darwinbeing/HPServerPSUHack/resources/PD52_04F/readme.md

# ICSP Header pinout
- 1 - GND
- 2 - MCLR
- 3 - PGED2
- 4 - PGEC2
- 5 - VDD

# Pickit 3 Pinout
- 1 - MCLR
- 2 - VDD
- 3 - GND
- 4 - PGD
- 5 - PGC

# Resistor values to modify output voltage
Originally both marked resistors are 20k
If changed to:
 - 23.2k = ~13.8V
 - 24k = ~14.2V
 - 24.3k = ~14.4V
