darwinbeing/HPServerPSUHack/firmware/PICKit3-Pinout.png

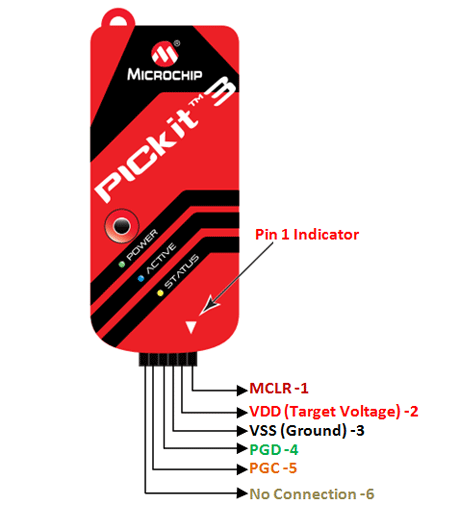
firmware/PICKit3-Pinout.png
