darwinbeing/HPServerPSUHack/references/dpsk3-power-buck-average-current-mode-control-1.0.1/docs/images/average-current-mode-control.png

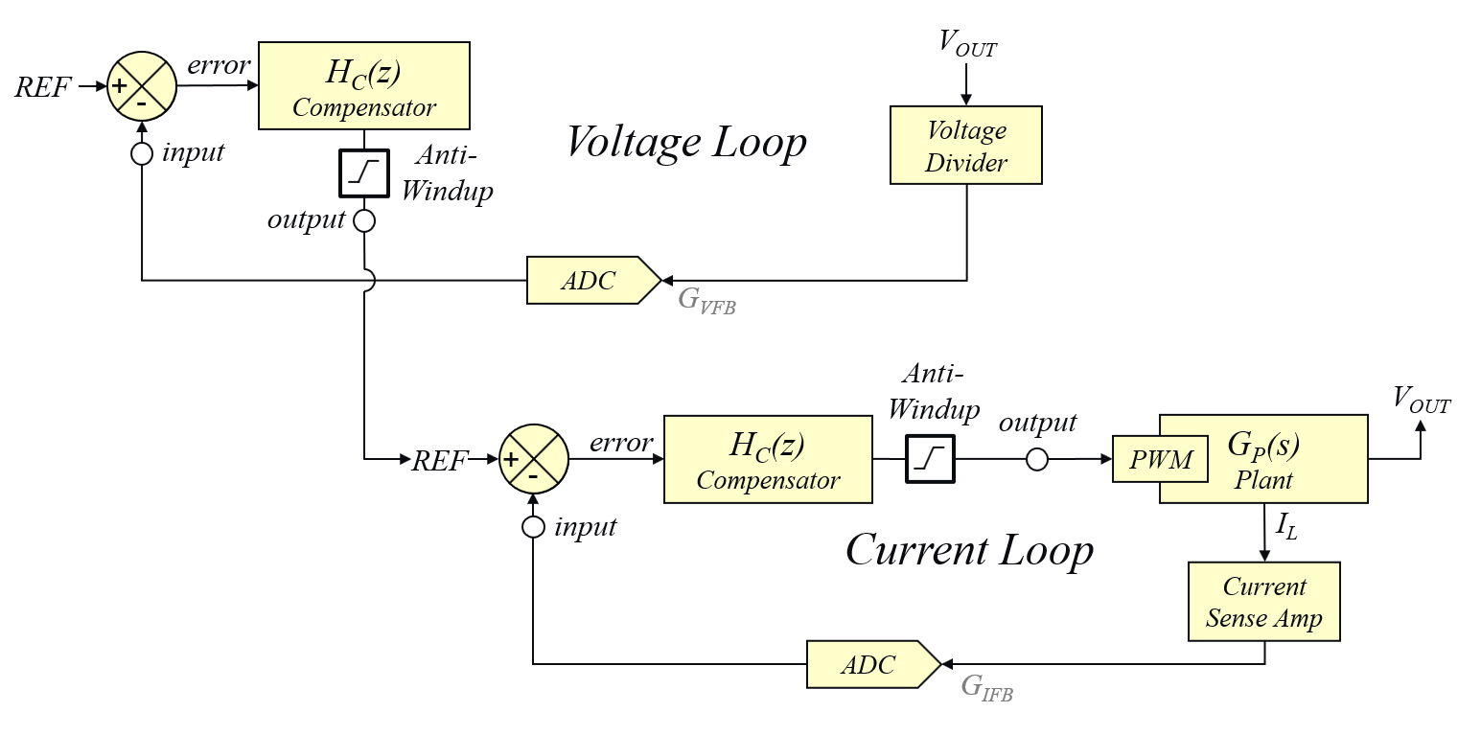
references/dpsk3-power-buck-average-current-mode-control-1.0.1/docs/images/average-current-mode-control.png
