darwinbeing/HPServerPSUHack/references/dpsk3-power-buck-average-current-mode-control-1.0.1/docs/images/control_timing.png

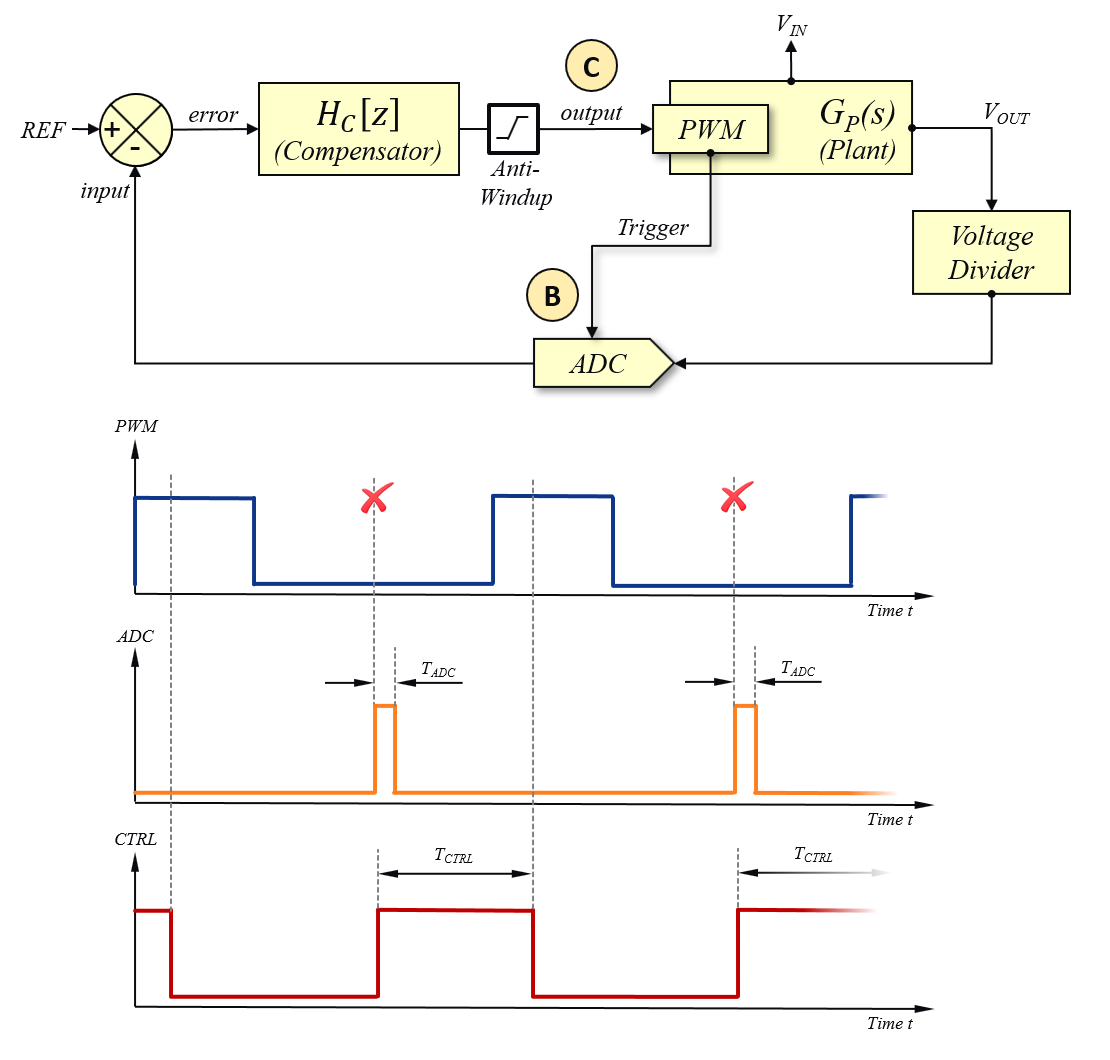
references/dpsk3-power-buck-average-current-mode-control-1.0.1/docs/images/control_timing.png
