darwinbeing/HPServerPSUHack/references/dpsk3-power-buck-average-current-mode-control-1.0.1/docs/images/fault_recovery.png

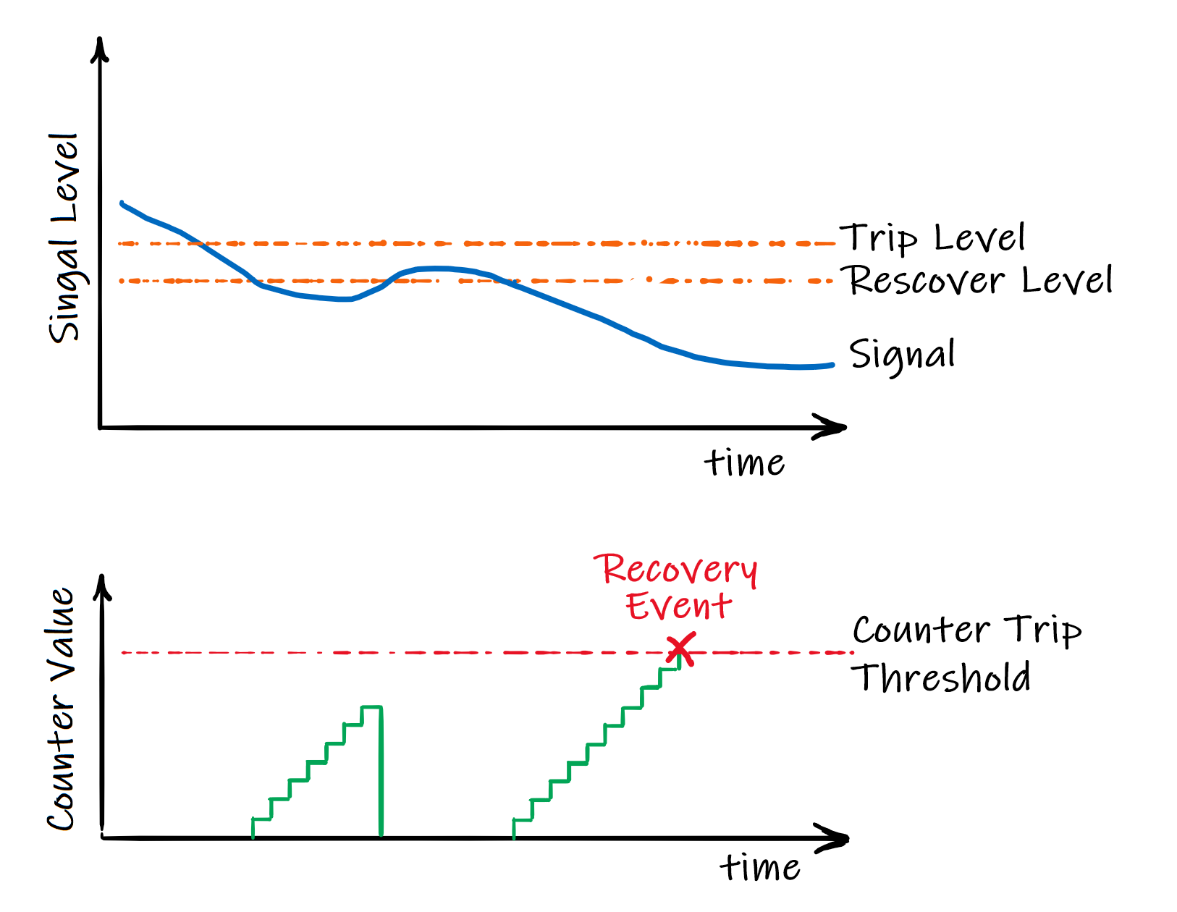
references/dpsk3-power-buck-average-current-mode-control-1.0.1/docs/images/fault_recovery.png
