darwinbeing/HPServerPSUHack/references/dpsk3-power-buck-average-current-mode-control-1.0.1/docs/images/irq_p0-2.png

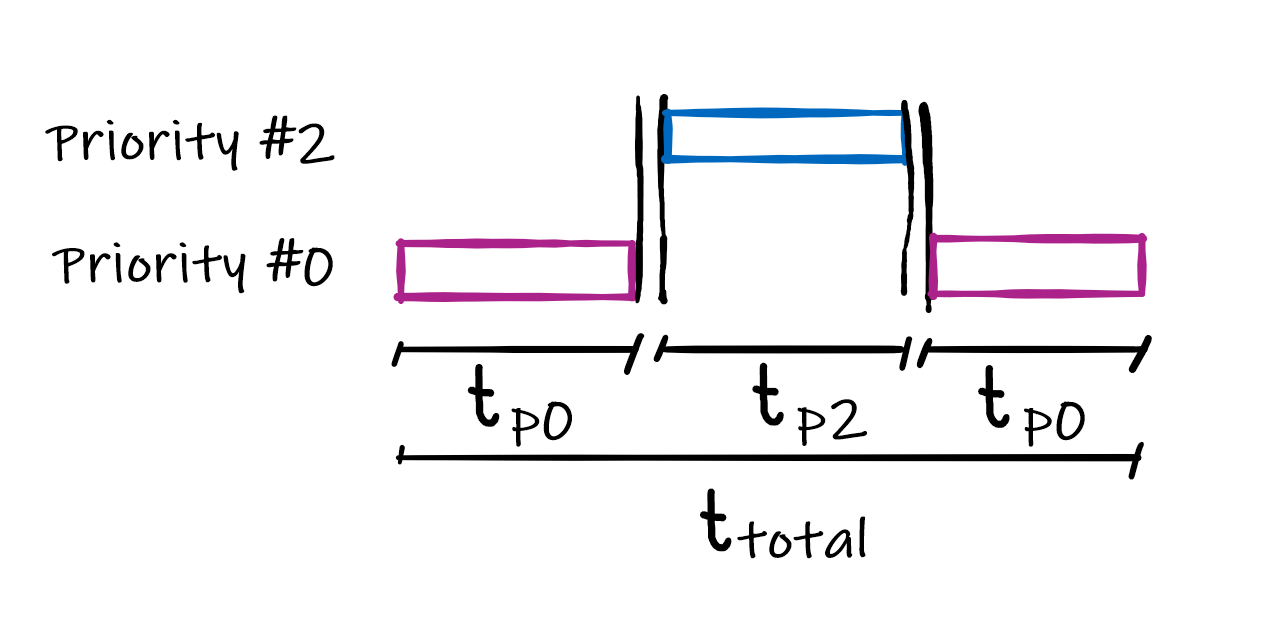
references/dpsk3-power-buck-average-current-mode-control-1.0.1/docs/images/irq_p0-2.png
