darwinbeing/HPServerPSUHack/references/dpsk3-power-buck-average-current-mode-control-1.0.1/docs/images/npnz16b-flowchart-agc.png

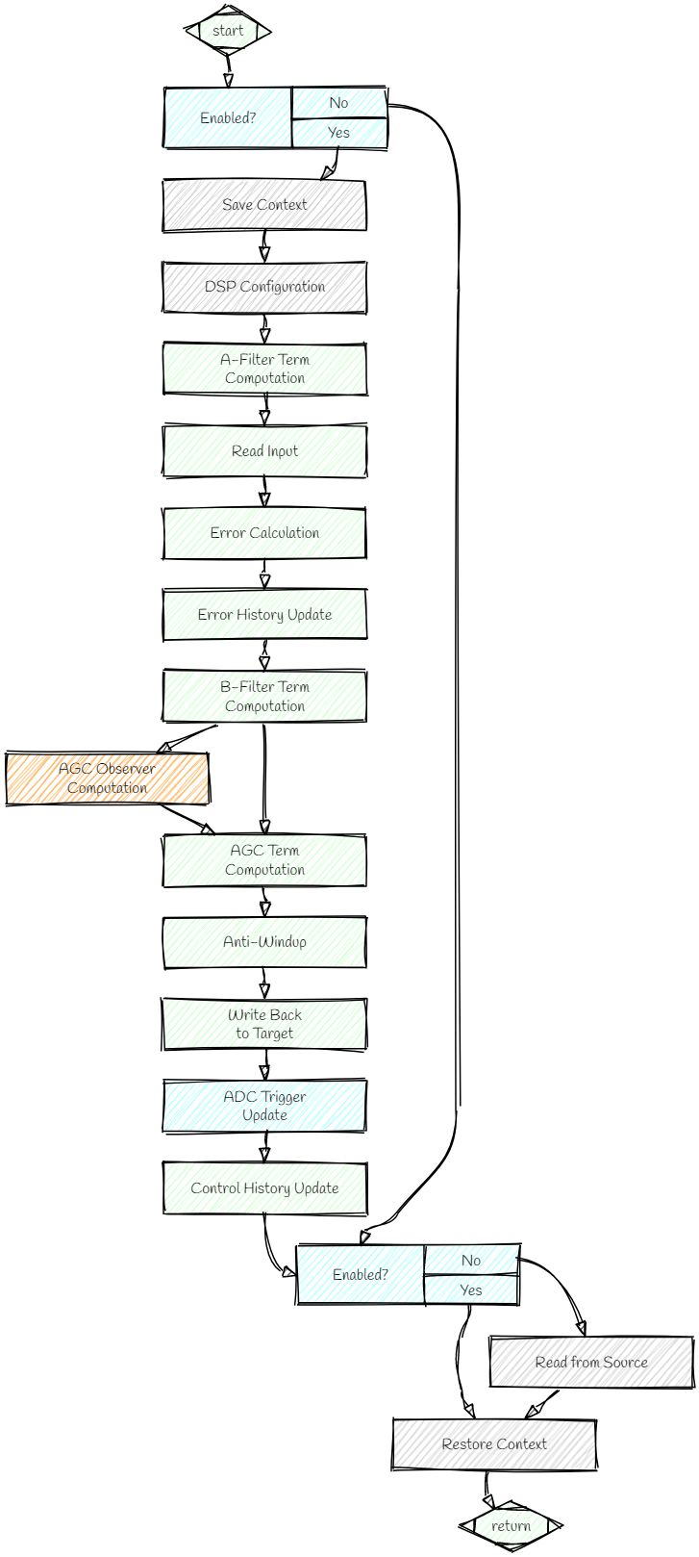
references/dpsk3-power-buck-average-current-mode-control-1.0.1/docs/images/npnz16b-flowchart-agc.png
