darwinbeing/HPServerPSUHack/references/dpsk3-power-buck-average-current-mode-control-1.0.1/docs/images/sfw_main.png

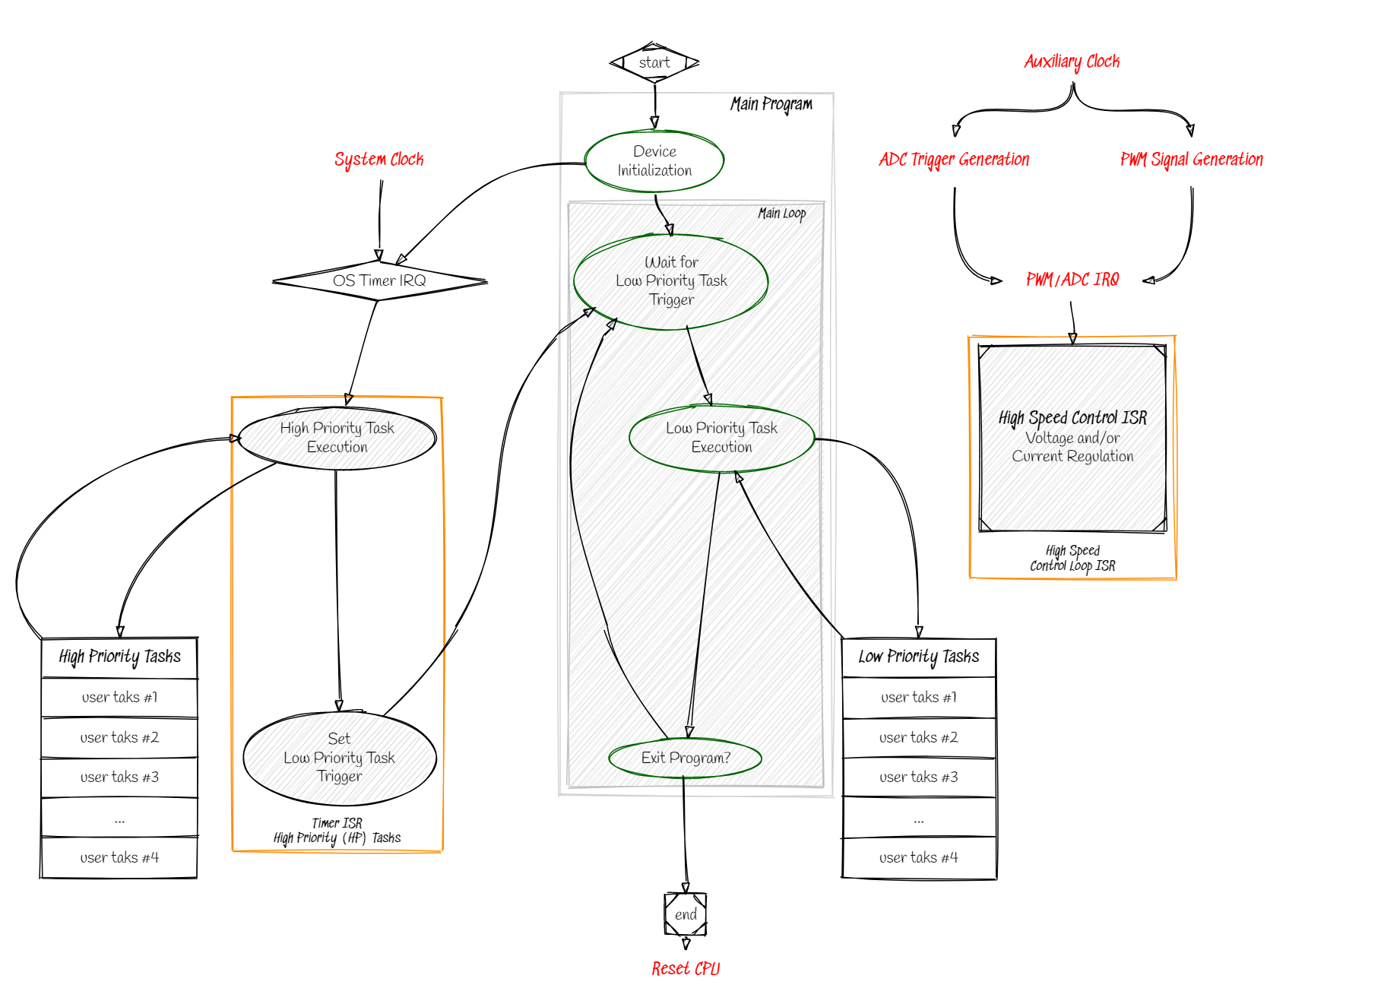
references/dpsk3-power-buck-average-current-mode-control-1.0.1/docs/images/sfw_main.png
