darwinbeing/HPServerPSUHack/references/dpsk3-power-buck-average-current-mode-control-1.0.1/docs/images/voltage-mode-control.png

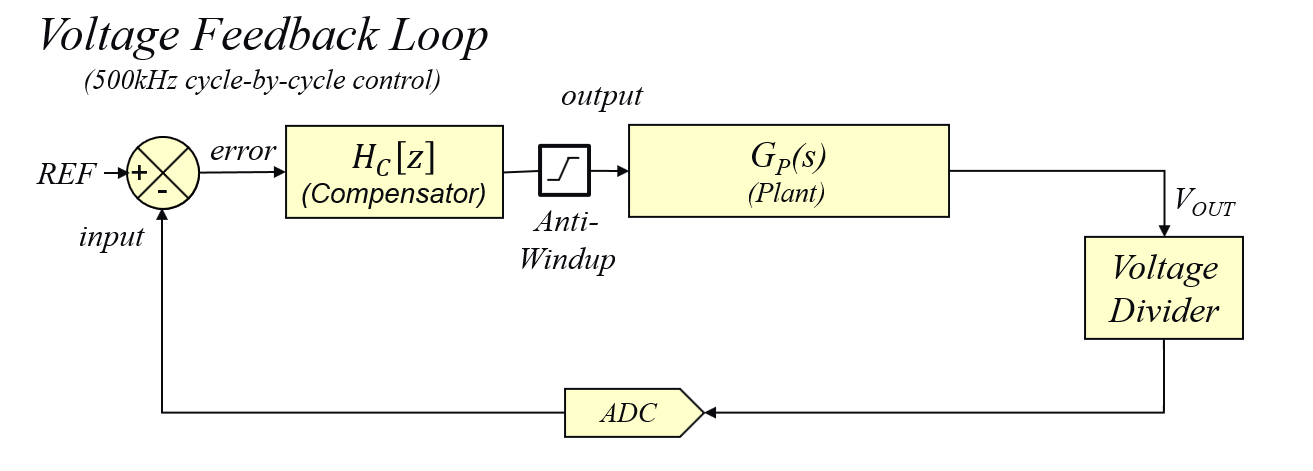
references/dpsk3-power-buck-average-current-mode-control-1.0.1/docs/images/voltage-mode-control.png
