darwinbeing/HPServerPSUHack/resources/cable.jpg

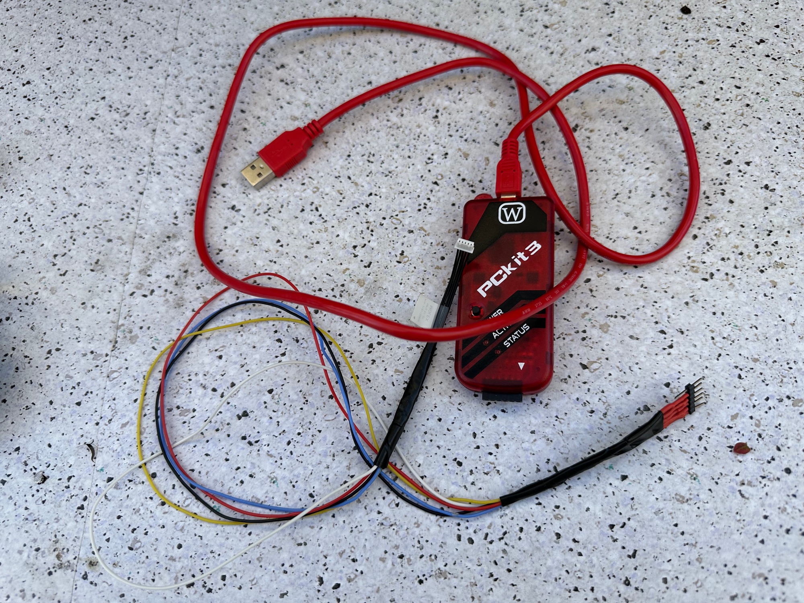
resources/cable.jpg
