darwinbeing/HPServerPSUHack/resources/connector.jpg

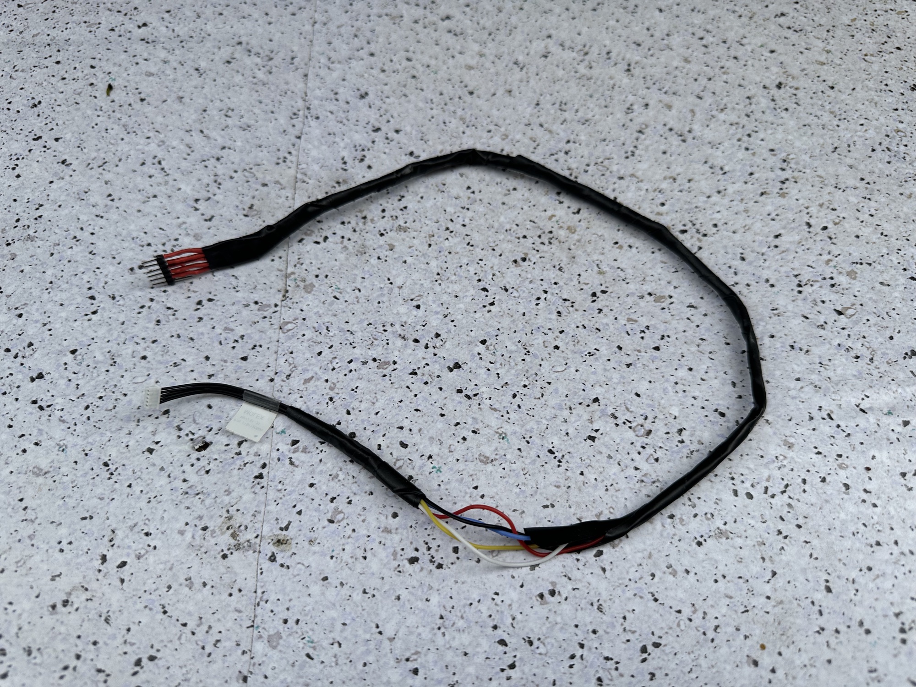
resources/connector.jpg
