darwinbeing/HPServerPSUHack/resources/D1600E-S0_MOD_SCH.png

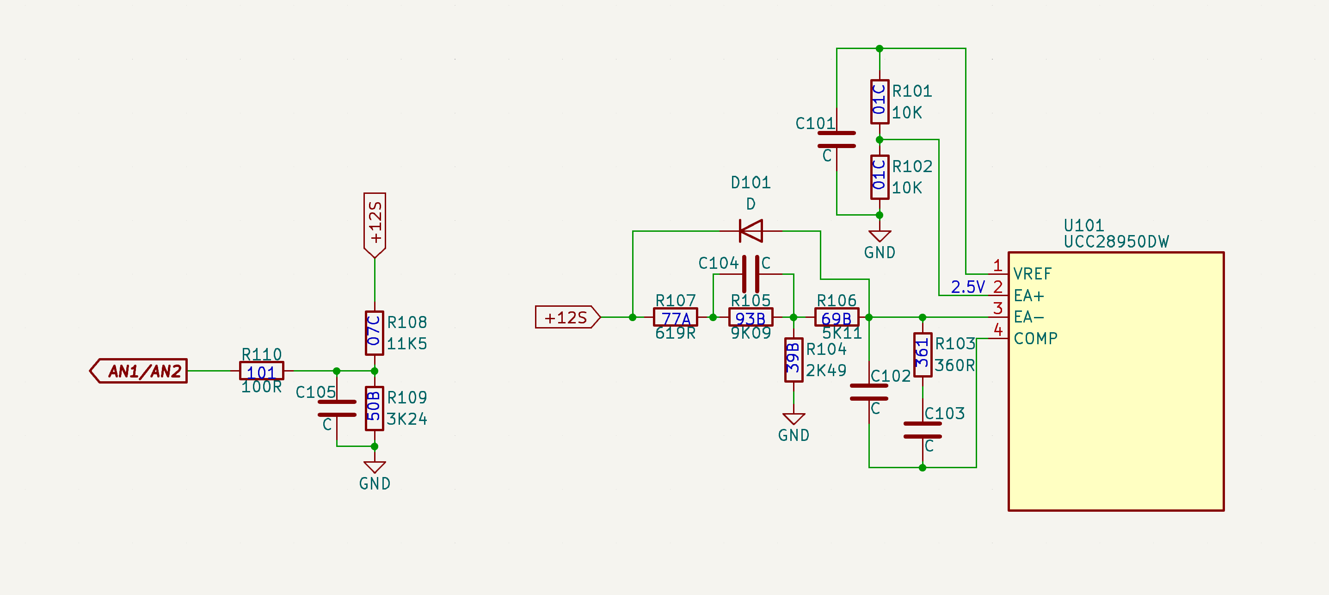
resources/D1600E-S0_MOD_SCH.png
