darwinbeing/HPServerPSUHack/resources/mb_front.jpg

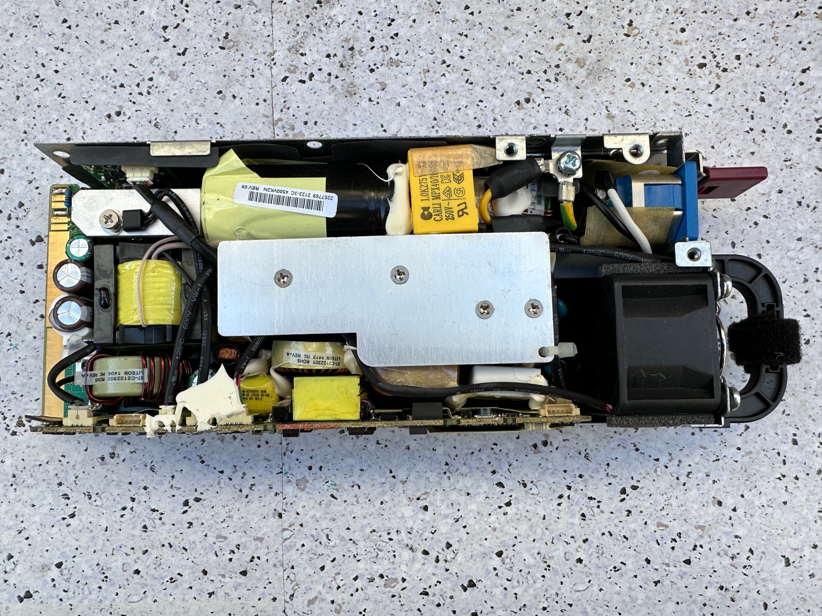
resources/mb_front.jpg
