darwinbeing/HPServerPSUHack/resources/PD19_MOD_SCH.png

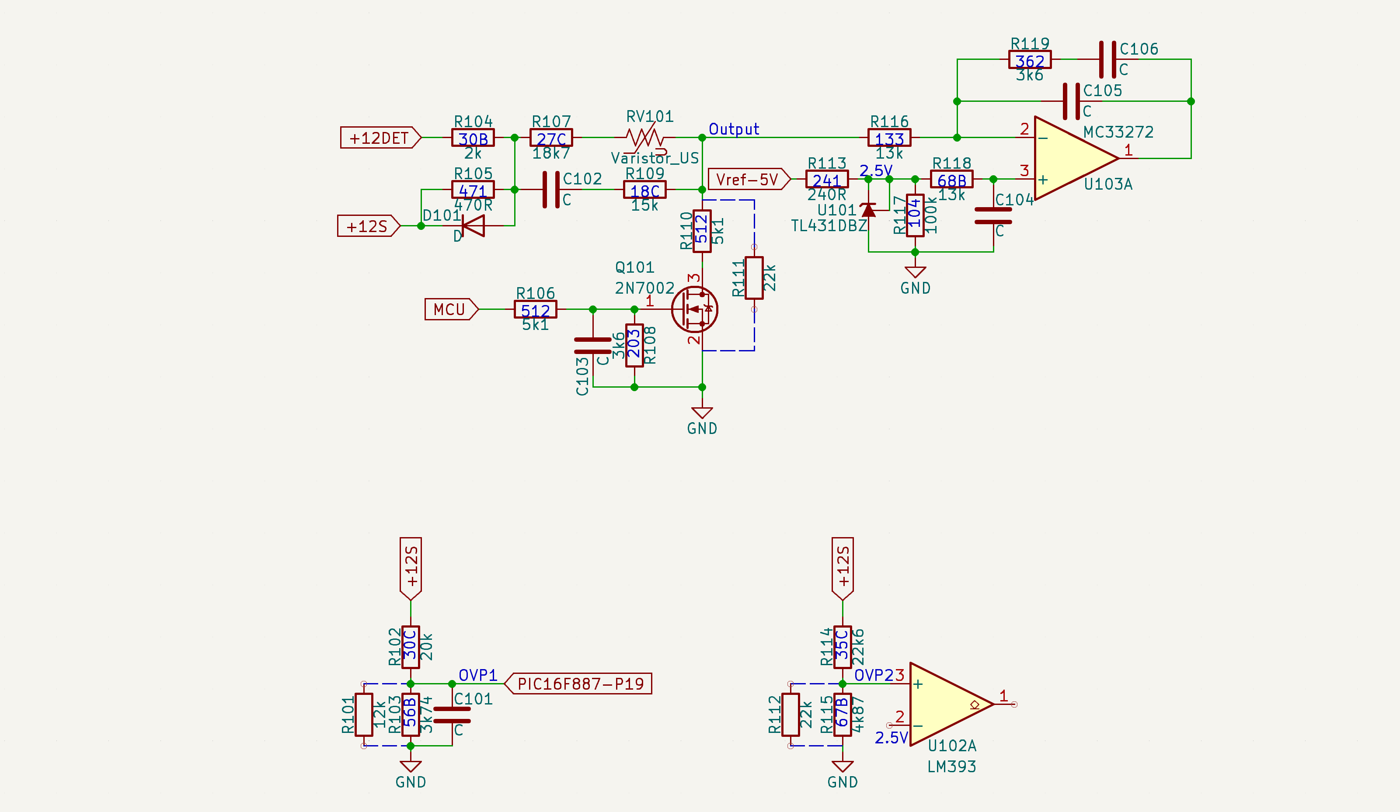
resources/PD19_MOD_SCH.png
