darwinbeing/HPServerPSUHack/resources/PD44_MOD_14V4.jpg

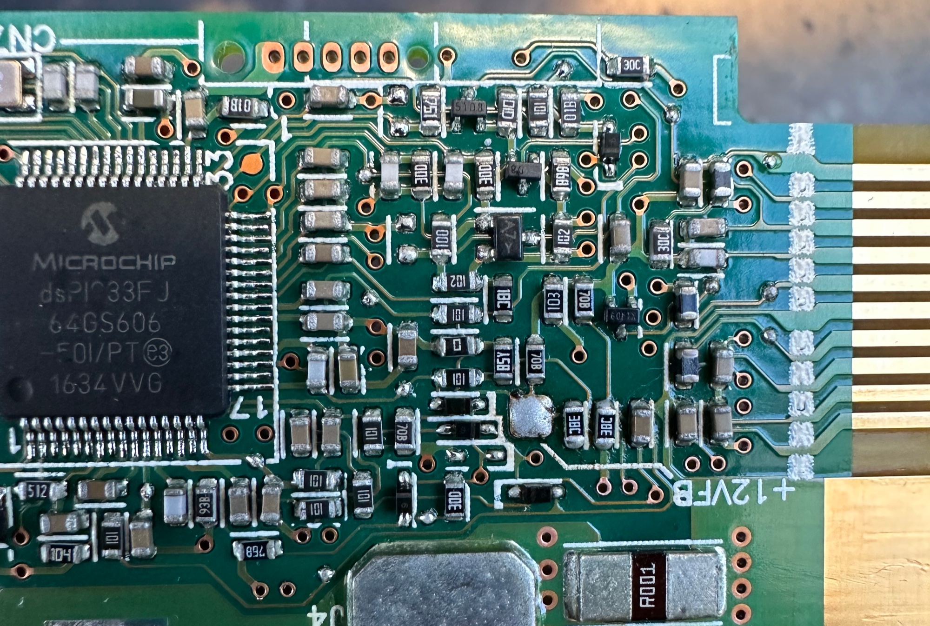
resources/PD44_MOD_14V4.jpg
