darwinbeing/HPServerPSUHack/resources/PD52_04F/icsp_and_pic.jpg

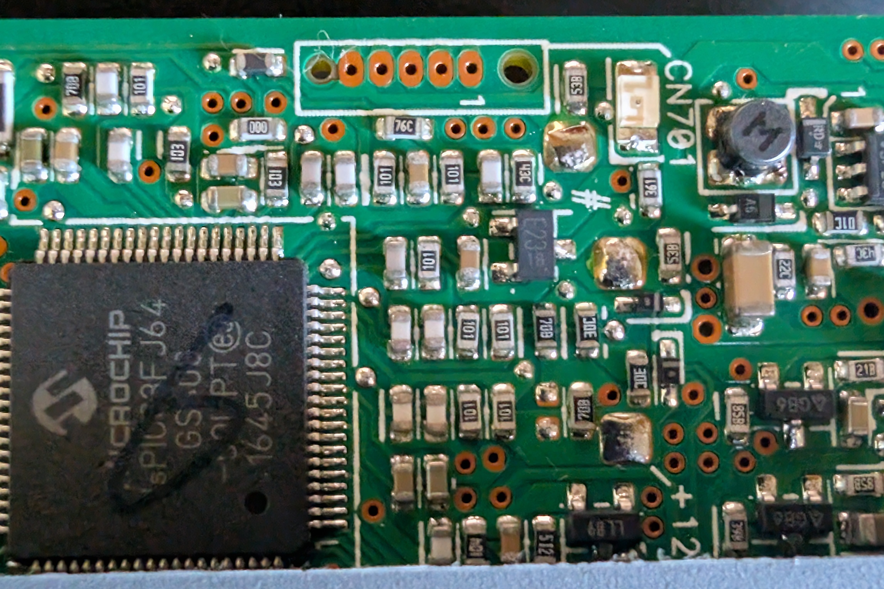
resources/PD52_04F/icsp_and_pic.jpg
