darwinbeing/HPServerPSUHack/resources/PD52_04F/vdiff_resistors.jpg

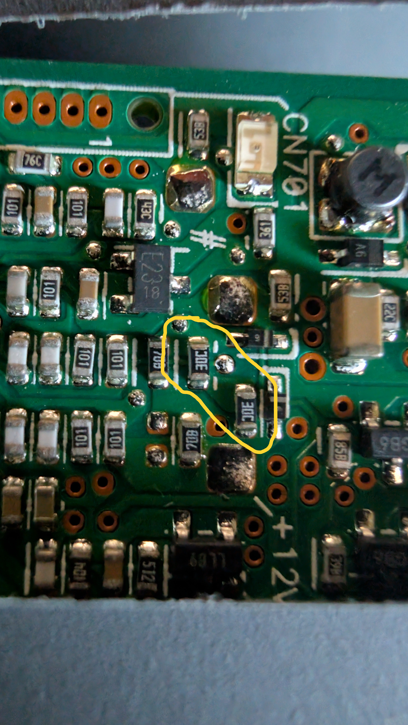
resources/PD52_04F/vdiff_resistors.jpg
