darwinbeing/HPServerPSUHack/resources/pickit3.jpg

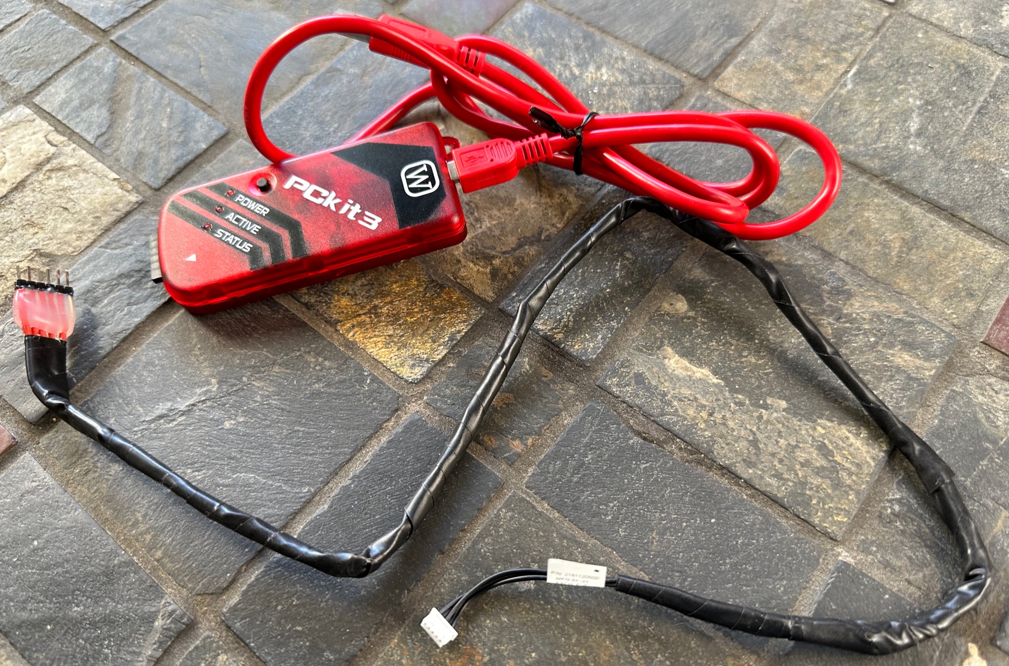
resources/pickit3.jpg
