darwinbeing/HPServerPSUHack/resources/PL11_BMW_LoadWithFanMax.jpg

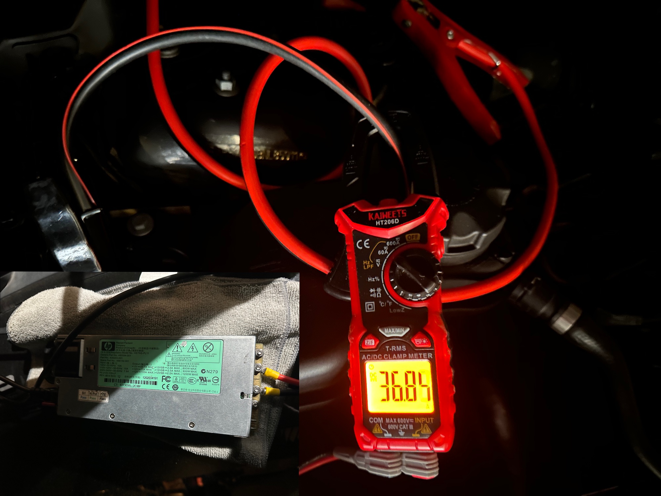
resources/PL11_BMW_LoadWithFanMax.jpg
