darwinbeing/HPServerPSUHack/resources/PL11_OCP_HW.png

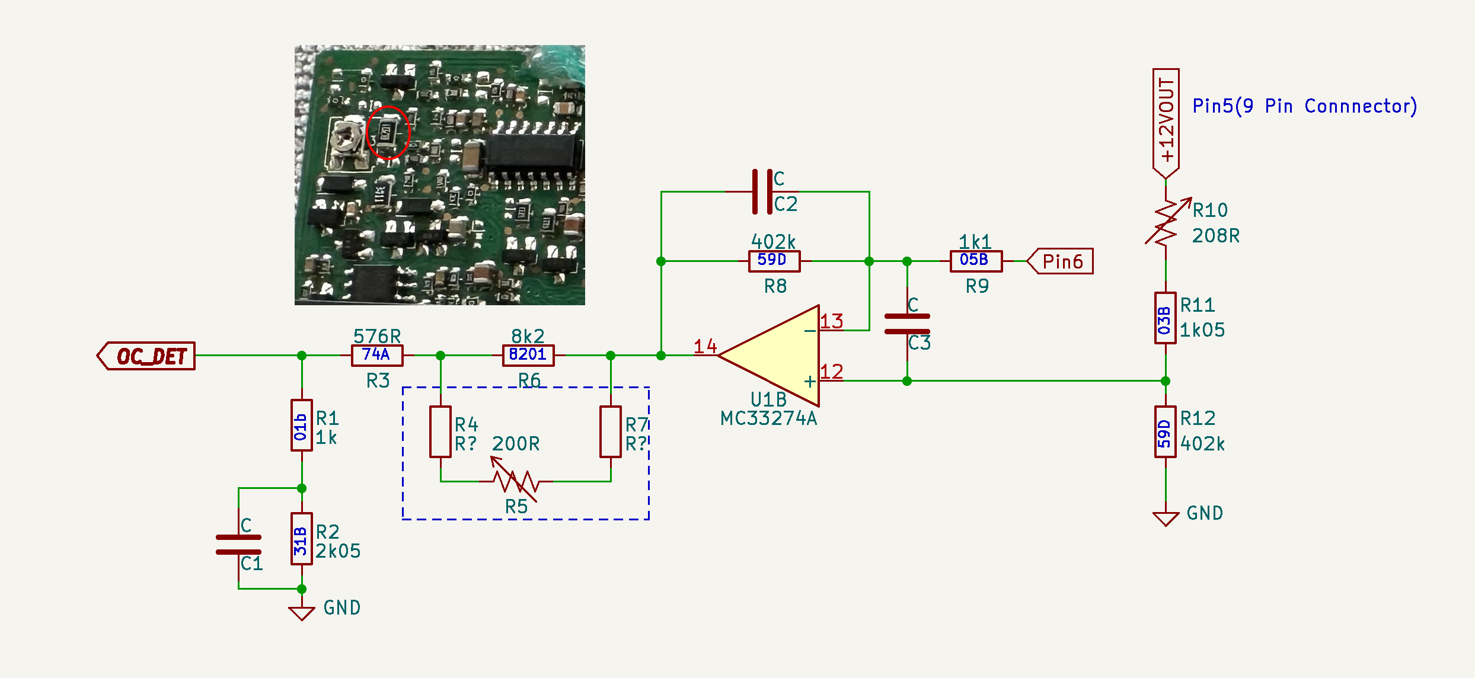
resources/PL11_OCP_HW.png
