darwinbeing/HPServerPSUHack/resources/PL30.jpg

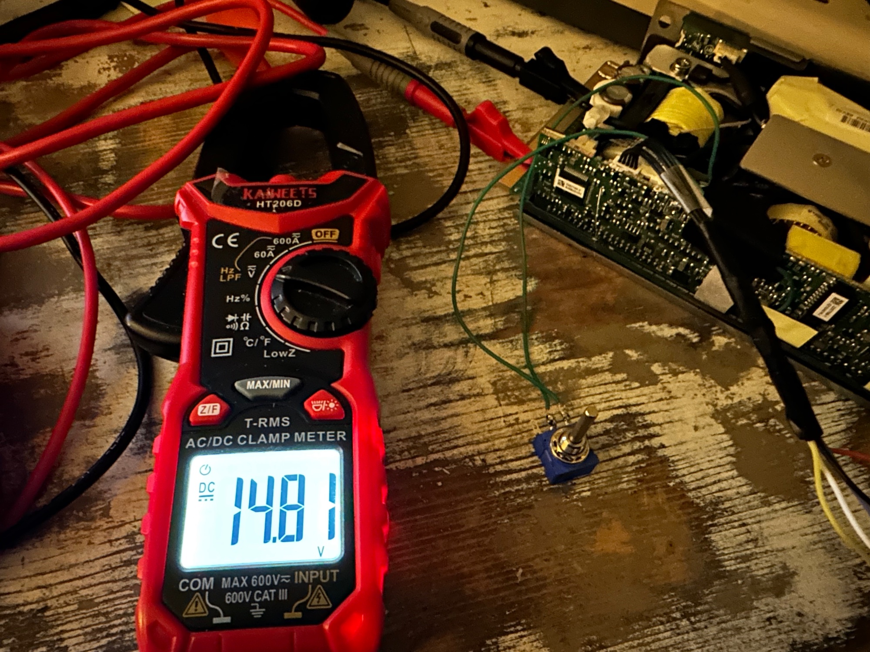
resources/PL30.jpg
