darwinbeing/HPServerPSUHack/resources/PL30_OCP_HW.png

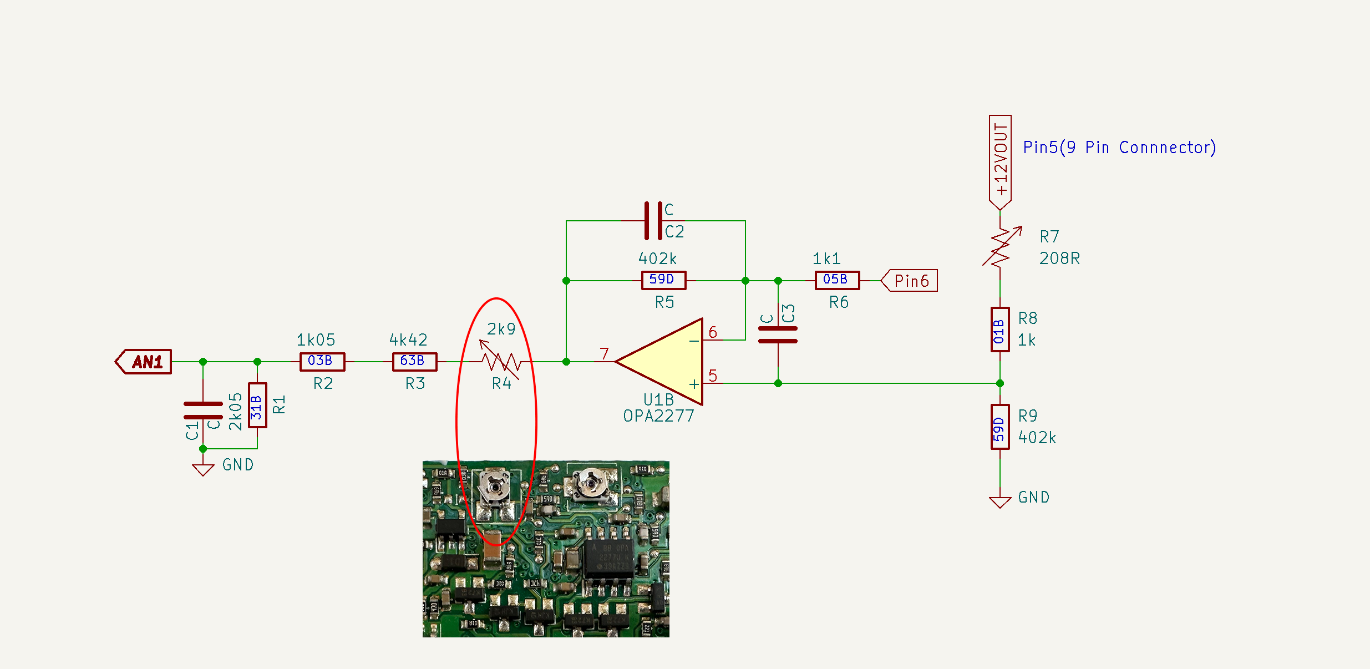
resources/PL30_OCP_HW.png
