darwinbeing/HPServerPSUHack/resources/PL30_OVP_BOTTOM.jpg

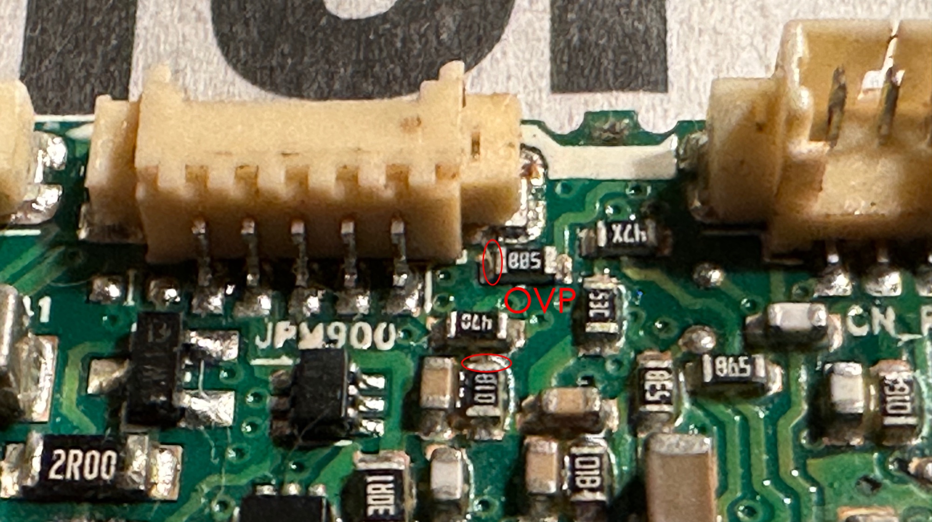
resources/PL30_OVP_BOTTOM.jpg
