darwinbeing/HPServerPSUHack/resources/PL30_OVP_HW.jpg

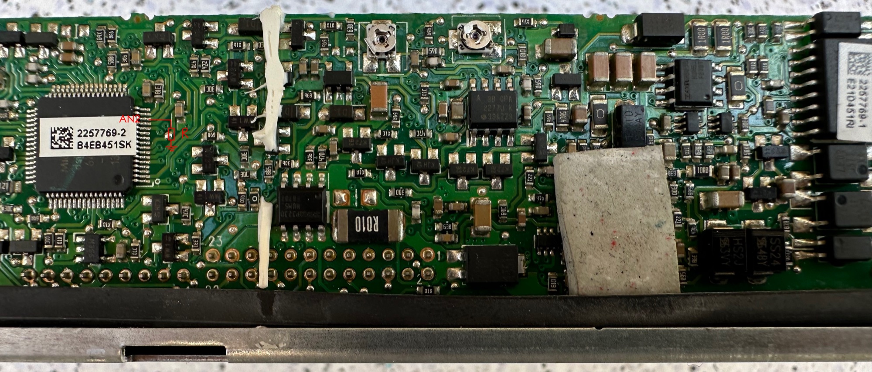
resources/PL30_OVP_HW.jpg
