darwinbeing/HPServerPSUHack/resources/sb1_back.jpg

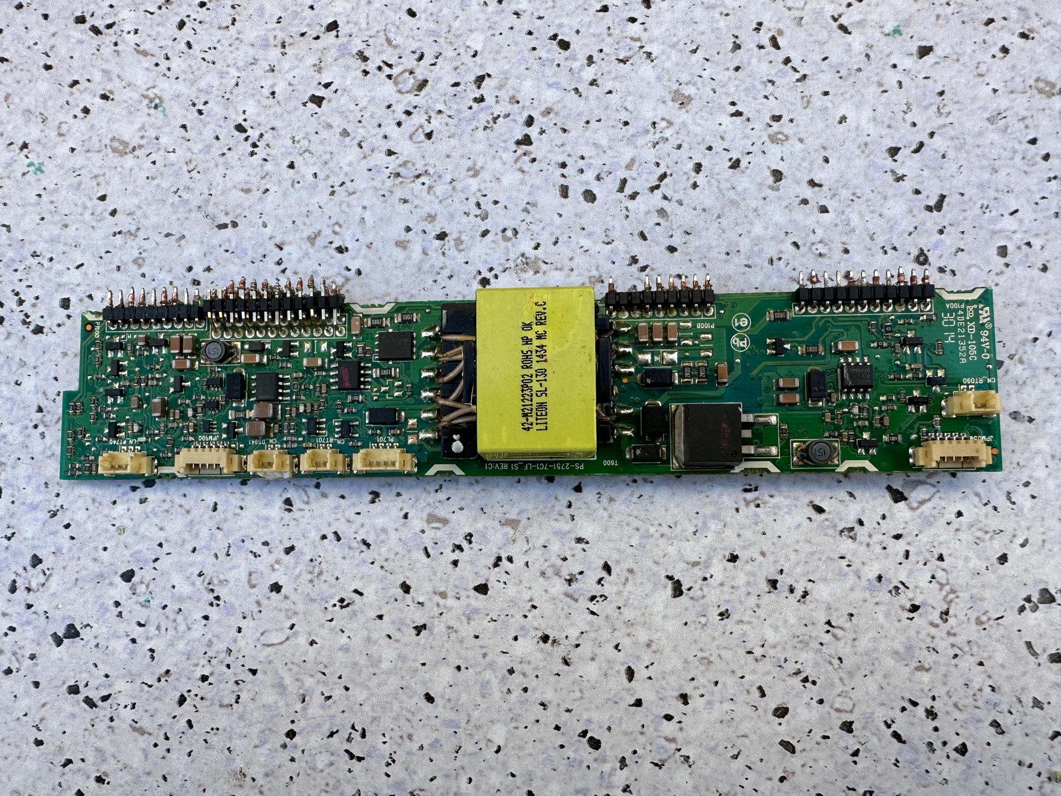
resources/sb1_back.jpg
