darwinbeing/HPServerPSUHack/resources/sb1_front.jpg

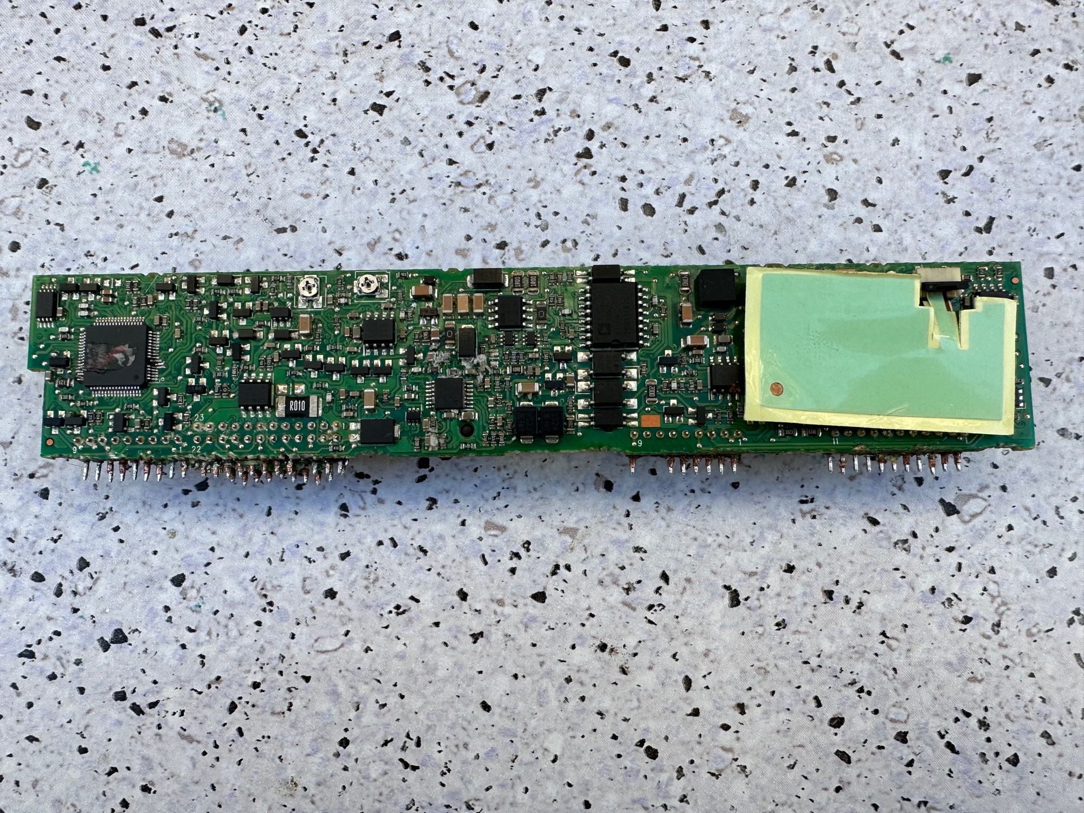
resources/sb1_front.jpg
