darwinbeing/HPServerPSUHack/resources/VR.jpg

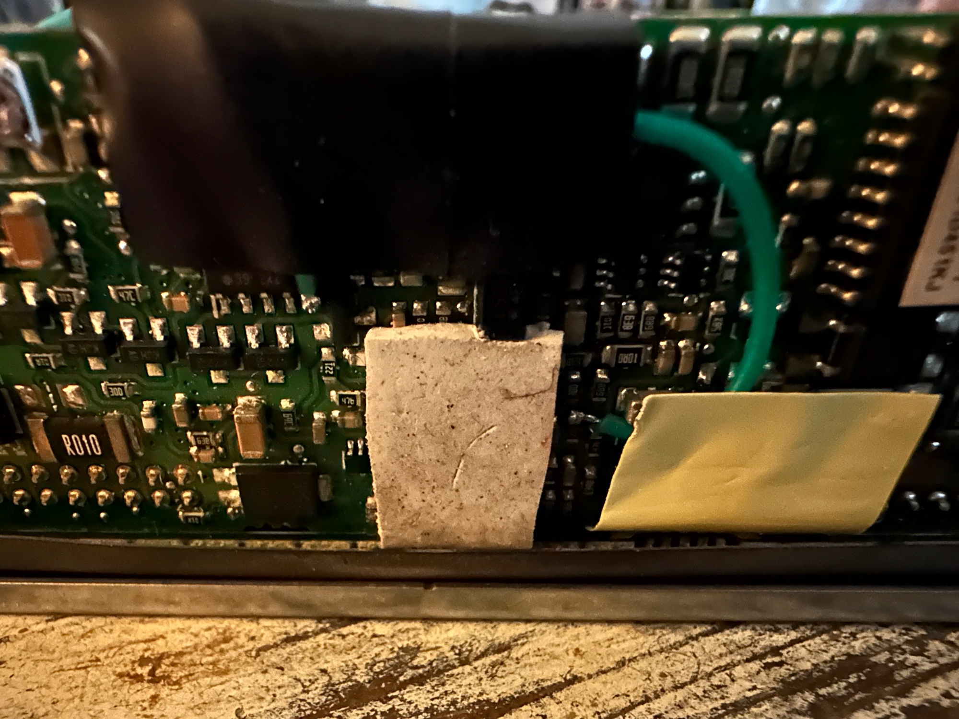
resources/VR.jpg
