darwinbeing/HPServerPSUHack/resources/load_test_current.jpg

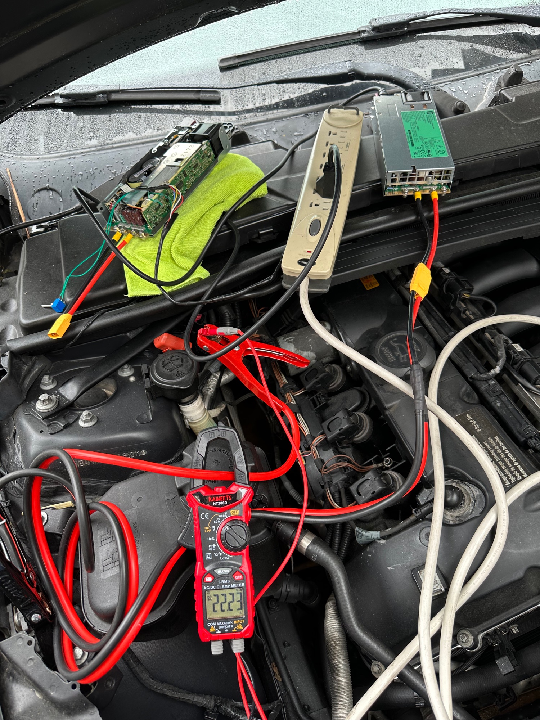
resources/load_test_current.jpg
