darwinbeing/HPServerPSUHack/resources/load_test_voltage.jpg

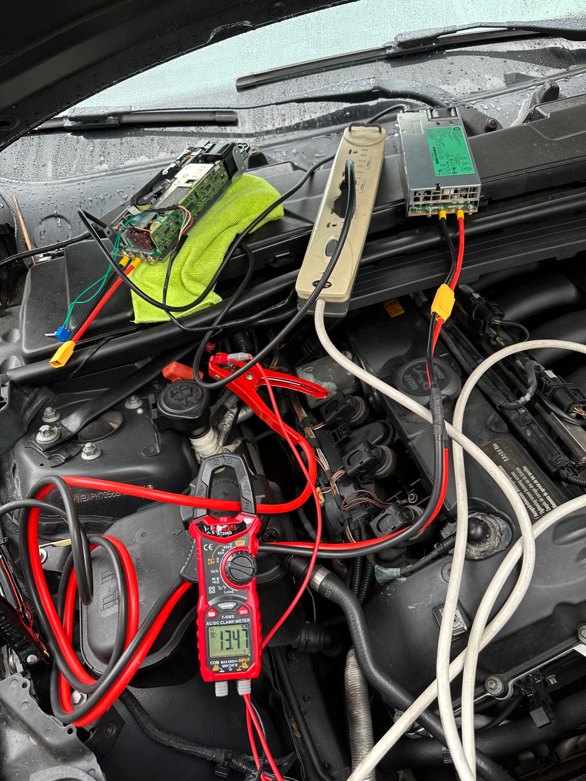
resources/load_test_voltage.jpg
