darwinbeing/HPServerPSUHack/resources/PL42BMWLoadTest.jpg

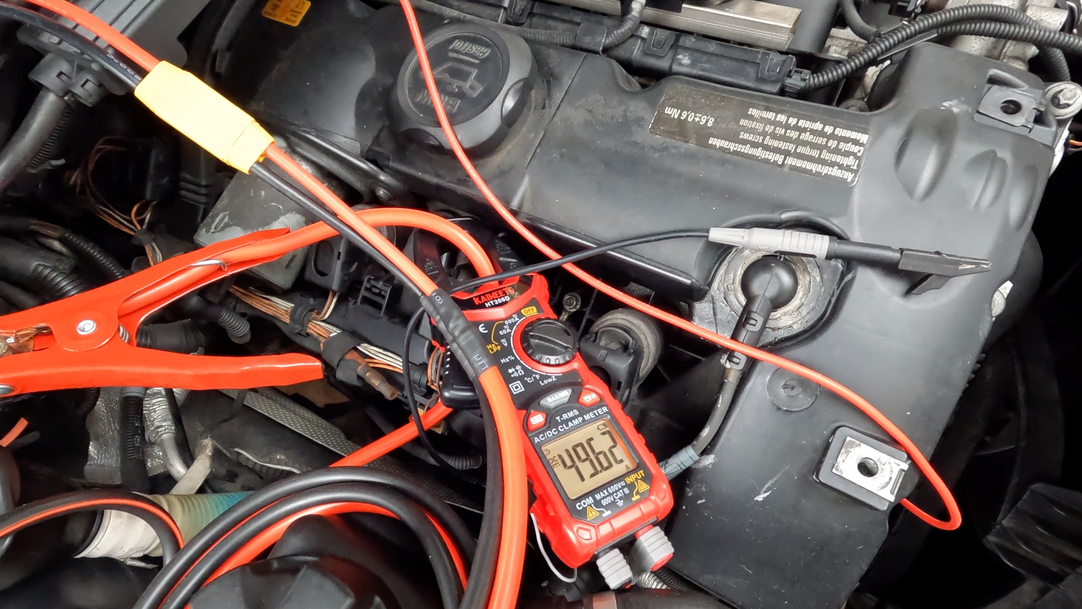
resources/PL42BMWLoadTest.jpg
