darwinbeing/HPServerPSUHack/(threads)

Thread 1 (2023-08-08):

Decrease output voltage for HSTNS-PL11

gotofbi, 2023-08-08:
Hi,

If I want to decrease voltage to 10.2v, how can I achieve this?
When I used the calculator, it showed negative resistor which doesn't make sense ;)

darwinbeing, 2023-08-08:
[[WolframAlpha Solver Output 10.2V](https://www.wolframalpha.com/input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)](https://www.wolframalpha.com/input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)
The approach of using resistors in parallel is only effective for increasing output voltage; it cannot be employed to decrease the output voltage. To achieve a reduction in the output voltage, resistor substitution is necessary. Based on the given formula:
R_11=1411 R_12=2.53
For obtaining an output voltage of 10.2V, the utilization of parallel resistors is no longer viable. Instead, it is required to substitute resistor R_123 with a 411-ohm resistor, and simultaneously replace resistor R102 with a 2.53 k-ohm resistor.

Closed 2023-09-04.

Thread 2 (2023-08-10):

PD30

pulp187, 2023-08-10:
Hi,

do you have a patch for PD30?  I noticed you have the original PD30 firmware. Did you use the same location to download the firmware? PD30 has only an empty space for the connector on the PCB.  Thanks for sharing all of the info.

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

darwinbeing, 2023-08-10:
### In-Circuit Serial Programming and Debugging Pinout

Pin1 - GND
Pin2 - $\overline{\textrm{MCLR}}$
Pin3 - PGED
Pin4 - PGEC
Pin5 - Vcc(3.3V)

Closed 2023-09-16.

Thread 3 (2023-09-16):

PL30

xrayos, 2023-09-16:
do you have a high resolution image of the soldering points for the resistor to increase the voltage? also, which resistor did you use in your final product that you use for coding the bmw. I'm trying to do the same thing. thanks!

darwinbeing, 2023-09-16:
### HERE IS MY PL30 OUTPUT 14.4V FOR BMW CODING SETUP
OUTPUT: 1.27K(TO GROUND)
OVP: 4.7K(TO GROUND)
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

xrayos, 2023-09-16:
thank you! I'm going to try and patch firmware for OVP

Which are you using for ground to change the output to 14.4v?

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

darwinbeing, 2023-09-16:
Same as the markings in the diagram you provided.

xrayos, 2023-09-16:
Thanks!

what about the 2 potentiometers at the top of the board? can they be use to change the voltage?

darwinbeing, 2023-09-17:
Using a potentiometer would make it more convenient to adjust the output.

xrayos, 2023-09-17:
what about these two by the arrows? Can they be used to adjust the voltage? Thanks!

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

darwinbeing, 2023-09-17:
No, they cannot.

cotfas, 2025-02-05:
I am also interested about those two adjustable resistors (potentiometers) at the top.

I have the PL30 and I want to know what are those two pots for?

I think my SMPS is current limited, as I can't draw more than 15amps from it? (I think).

Closed 2023-09-20.

Thread 4 (2023-11-07):

PICO watt meter firmware

NobodyYouKnow, 2023-11-07:
My Google-Fu is failing me on this one. What is the provenance of the firmware for the PICO wattmeter used in this repository? I am looking for the source code to learn from and tweak. Thanks!

darwinbeing, 2023-11-08:
[Raspberry Pi Pico Watt Meter Source](https://github.com/darwinbeing/zpsu_mon)

NobodyYouKnow, 2023-11-09:
Thank you!

Closed 2023-11-09.

Thread 5 (2023-12-08):

HP HSTNS-PD18

flywire, 2023-12-08:
Does this adapt to the HP HSTNS-PD18 (DPS-750RB A) for 14.4V?

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

 It has a different daughterboard.

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

ra1nb0w, 2024-02-02:
Do you know if the i2c is also usable on this PSU? thanks

darwinbeing, 2024-03-04:
@ra1nb0w
I don't have access to this power supply, so I can't confirm if it supports accessing electrical parameters via I2C. It's highly possible that this power supply doesn't support it.

Closed 2024-03-13.

Thread 6 (2024-02-03):

hstns-pl30 - Anyone up for giving me some guidance?

mike-newman, 2024-02-03:
Hello,

Been trying to understand the documentation here and procedures to modify my hstns-pl30 for coding my BMW E66. The goal is to mod the  hstns-pl30 for 14.7 volts and max avaialble AMPs (80AMP?)

So far I have been aboe to add the resitor to power on the unit, I have 12.3 volts when powered on. Where I need assistance is the correct reistors and placement needed to bring the voltage up above 14v and OVP so the unit doenst shut off. I cant tell if I need to both solder the resitors and or program the unit.

I see the images provided in the repo but cant really tell exactly where to solder.

Please any assistance is appreciated.

Mike

darwinbeing, 2024-02-11:
$`R_1{\approx}1.1Kohms`$
$`R_2{\approx}4.12Kohms`$

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

Closed 2024-02-22.

Thread 7 (2024-03-03):

HP HSTNS-PD19

pan-sattan, 2024-03-03:
Hi,

quick question... when I add the resistors as on your pictures... will it work? Or should be modified somehow the software?

Thank you for clarification

darwinbeing, 2024-03-04:
If you set the power supply output voltage to 14.4V, use resistor values as follows: OVP1: approximately 17k, OVP2: 22k, OUTPUT: 22k.
If you set the power supply output voltage to 14V, use resistor values as follows: OVP1: 22k, OVP2: 28k, OUTPUT: 28k.
Attention: Please note that the resistor paralleled with OVP1 is prone to lifting pads during soldering. Therefore, replacing it with a 0603-size resistor would make soldering easier.

pan-sattan, 2024-03-04:
thank you for answer... I need something about 14,8V. On my shop floor is present hot air gun and special equipment... I prepared  OVP1 12K OVP2 22K and Output 22K

darwinbeing, 2024-03-08:
To achieve a 14.8V output with the resistor values
OVP1 ~ 15.5kΩ
OVP2 ~ 19.2kΩ
OUTPUT ~ 19.2kΩ

pan-sattan, 2024-03-10:
> If you set the power supply output voltage to 14.4V, use resistor values as follows: OVP1: approximately 17k, OVP2: 22k, OUTPUT: 22k. If you set the power supply output voltage to 14V, use resistor values as follows: OVP1: 22k, OVP2: 28k, OUTPUT: 28k. Attention: Please note that the resistor paralleled with OVP1 is prone to lifting pads during soldering. Therefore, replacing it with a 0603-size resistor would make soldering easier.

I am just preparing components... and thinking.. do you mean to replace whole resistor placed on board for OVP1 17k?? when I replace it, will it be OK? I found only 16,9K 0603 resistor...

concider that 14,4V will be good enough for me

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

darwinbeing, 2024-03-10:
Yes, both options should work. You can either parallel another resistor to achieve a value close to 16.9k, or you can replace it with a 3k 0603 resistor.

[YAGEO Through Hole 16.9K MFR-25FBF52-16K9](https://www.mouser.com/ProductDetail/YAGEO/MFR-25FBF52-16K9?qs=oAGoVhmvjhwdC5bv3mq7Dw%3D%3D)
[YAGEO 0603 3K RT0603DRD073KL](https://www.mouser.com/ProductDetail/YAGEO/RT0603DRD073KL?qs=4CyHz7GXqSgg8wnv2%2FaYDw%3D%3D)

Closed 2024-03-13.

Thread 8 (2024-03-14):

could you add a PL41 these r very cheap now but it is unknown how to adjust voltage it does not have any pots just op amps

Crunch69, 2024-03-14:
could you add a PL41 these r very cheap 800W 2 for $23 shipped now but it is unknown how to adjust voltage it does not have any pots just op amps.  in parallel you get a 24v 1600W supply.  it would be fantastic if we could get 26-28v out of them

darwinbeing, 2024-05-05:
I don't have access to that power supply. Could you share a few clear close-up photos of it?

Closed 2024-06-10.

Thread 9 (2024-08-30):

Vout and OVP for HSTNS-PF43

ogni846, 2024-08-30:
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

Added a change to OVP and Vout.
Now I'm looking for a solution to control the output current!

darwinbeing, 2024-09-03:
PMP9622
350W Constant Voltage - Constant Current (CVCC) Phase-Shifted Full Bridge reference design
https://www.ti.com/lit/df/tidrde5/tidrde5.pdf

ogni846, 2024-09-03:
Now I've put PF43 aside for now, there's not enough material for reworking. I bought PL18 rev15, I'll try it on it3 сент. 2024 г., в 17:40, LI Tao ***@***.***> написал(а):
PMP9622
350W Constant Voltage - Constant Current (CVCC) Phase-Shifted Full Bridge reference design
https://www.ti.com/lit/df/tidrde5/tidrde5.pdf

—Reply to this email directly, view it on GitHub, or unsubscribe.You are receiving this because you authored the thread.Message ID: ***@***.***>

darwinbeing, 2024-09-06:
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
This can be done using CC-CV control using two feedback loops; one two regulate the maximum output voltage and the other to regulate the maximum output current. The two control loops are OR'd together. The control loop with the lowest error "wins" and controls the output.

IceShiva, 2024-09-07:
Dont forget about the complex poles and zeros in compensation. Of course you can use +1uf cap  integrator in current loop. Psu would be very slow but will works. Second way is use mcu in the loop, extract parameters from analog voltage loop, implement it in digital way and tune it, or open the loop and design new one. Most of server psu's has a current share loop which is not acceptable for charnig batteries and powering leds, because it's implemented as kind of constant resistance, so if impedance of reciver changes current grows up then you need to adjust reference for current share loop. Another limitation is CCM/DCM mode and frequency of operation (Ton/Tof). Good point of start is having oscilloscope, signal generator, dummy load and alot calculations.

darwinbeing, 2024-09-07:
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
Thanks for the insights! Regarding hardware modifications, I completely agree that they can introduce instability and unreliability into the power supply. It’s interesting that the HP HSTNS-PL30 doesn’t use the UCC28950 Phase-shifted full-bridge chip and instead implements control in the secondary MCU firmware. Rewriting the secondary firmware could potentially enable constant current mode with minimal hardware changes.

Closed 2024-10-09.

Thread 10 (2024-09-23):

HSTNS-PL42 OVP Firmware

klippard, 2024-09-23:
I have applied the firmware patch to an HSTNS-PL42 supply, and it does not seem to have any affect at all on the OVP protection.

darwinbeing, 2024-09-23:
Could you upload the original firmware here?

klippard, 2024-09-23:
[HSTNS-PL42 factory.zip](https://github.com/user-attachments/files/17100059/HSTNS-PL42.factory.zip)

klippard, 2024-09-23:
I even tried applying the original PL42 firmware you have posted here, then re-applied the patch.  OVP is still kicking in at around 13V.

klippard, 2024-09-23:
My apologies.  It's working after putting a legitimate voltmeter on it.  The breakout board I was using on the PSU wasn't showing the voltage increase for whatever reason.

Closed 2024-09-23.

Thread 11 (2024-11-13):

PL-11 OCP mode problem

NazikSoft, 2024-11-13:
Hi, I have two PL11 (rev 9 and 12). I going to use them as chargers for my battery.

I've Increased out voltage up to 14,4v using your way

To brake OVP I used different solution, I've replaced resistor 4,9k (R900 on scheme) to 5,6k.
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

As a result, all works well, but... If I start charging with 14,4v 110a, power supply shutdown, I guess this is some kind of total power protection. I've made your OCP mod, add resistor and have tried to set limit 60A, my BMS show charging current as 60a, but pl11 start buzzing and shutdown in 5-8sec, green led turn off. Looks like power supply is overloaded

Could you please help me? Does my ovp wrong? Or this OCP mod is not fit for my situation? Thanks!

darwinbeing, 2024-11-22:
The load is too high, causing the power supply to trigger overcurrent protection. It’s best to use multiple power supplies in parallel to provide a higher output current.

NazikSoft, 2024-11-23:
Can I disable overcurrent protection? Could you tell please, why I have an overcurrent protection when I set output current as 60a? It's only a half of supply power

darwinbeing, 2024-11-23:
You can set the OCP threshold very high, but if the load is too large and the output power exceeds the power supply’s rated capacity, overheating will still cause it to enter protection mode. If your output current is 110A and you set the OCP to 60A, it won’t make the power supply output a constant 60A; it will only trigger OCP earlier. This is not a constant current source and cannot ensure a stable output current. It is recommended to use multiple power supplies in parallel.

NazikSoft, 2024-12-01:
Thank for explanation

Closed 2024-12-01.

Thread 12 (2024-11-30):

PL30 OVP & Pico Display

WiredWonder, 2024-11-30:
Hi there,

Thank you for publishing your work! I have two questions if that's OK:

1. The Pico display seems to show the wrong voltage; using the pre-built firmware my output voltage before mods is 12.2v however the display shows 14.4v and 3A that do not change with low load. The watts shows 20W with no load but correctly goes up with small and large loads. Amps goes up with large loads >3A, but volts does not reflect measured volts.
2. What cable is required to do the OVP mod? I have some old PIC ISCP cables but not sure it will work.

My PSU is PL30 Rev 17.

Thanks!

darwinbeing, 2024-11-30:
You need to change the Gain in the code to 1 and recompile.
https://github.com/darwinbeing/zpsu_mon/blob/cfa0d3d58f343451c08e334653a570b61b1143b9/src/psu_ctrl.c#L219

darwinbeing, 2024-12-01:
[zephyr_pico_display_pack.uf2.zip](https://github.com/user-attachments/files/17969608/zephyr_pico_display_pack.uf2.zip)
[zephyr_pico_display_pack2.uf2.zip](https://github.com/user-attachments/files/17969609/zephyr_pico_display_pack2.uf2.zip)

darwinbeing, 2024-12-14:
[In-Circuit Serial Programming (ICSP) Guide](https://ww1.microchip.com/downloads/en/DeviceDoc/30277d.pdf)

Closed 2024-12-08.

Thread 13 (2024-12-03):

HSTNS-PL18 compatibility

nikosp11, 2024-12-03:
Could a similar approach be applied for a HSTNS-PL18?

darwinbeing, 2024-12-05:
Yes, it is possible that a similar approach to modifying the HSTNS-PL18 could work as with the HSTNS-PL11. However, it would be best if you could upload some images of the power supply, including close-ups of the control board or any labels, so we can analyze the specifics.

Thread 14 (2024-12-16):

Do i need to change OVP for pl30 to get a lower voltage than 12v?

xiaohu21500, 2024-12-16:
The output voltage depends on Rp, which is less than 220 ohm with a parallel resistance. Can i change R117(220ohm) to a larger value resister to get a lower output voltage?

xiaohu21500, 2024-12-16:
And in issue#1, author mentioned that OVP needs to be modified. is it necessary? can i modify the firmware instead?

darwinbeing, 2024-12-16:
Yes, replacing R117 with a larger resistor will decrease the output voltage. However, if the output voltage becomes too low, such as around 10V, it may trigger UVP (Under Voltage Protection). To address this, you'll also need to adjust the voltage divider resistors for OVP (Over Voltage Protection) or modify the firmware to accommodate the new settings.

xiaohu21500, 2024-12-18:
Thanks, modifying the firmware to close OVP seems to be a more elegant way, however i am not capable to decompile the .hex file. Looking forward to your update！：）

One more question,  is there a list of the register address for I2C communication? I believe reading voltage/current can be done with stm32, esp...... which are much cheaper.

IceShiva, 2024-12-18:
> Thanks, modifying the firmware to close OVP seems to be a more elegant way, however i am not capable to decompile the .hex file. Looking forward to your update！：）
>
> One more question, is there a list of the register address for I2C communication? I believe reading voltage/current can be done with stm32, esp...... which are much cheaper.

Registers needs to be reversed, it's basically uses pmbus with diffrent opcodes. Put your hex file on ida or ghidra and select proper mcu, I did some research how server is interacting with power supply in hp gen8-9 psus by decompiling ilo firmware, psu generally is runtime tuned to specific workload (transcient response) and power profile. Most recent psu uses specialized mcu's for power conversion system and it's fully digital but in most cases reading of firmware is hard or not possible. Hardware in 80+ Titanium psus with bridgeless pfc and resonant halfbridge/fullbridge allows bidirectional current flow, all what need to be done inspect hardware R/L/C of components in power block ( resonant tank if smps is soft switched, transformer ratio and inductance ), mcu board (nowdays these board have few pins (pwm out, sensing and power in)  and write new firmware.  I believe, some peoples in some day would start project's as ev conversion communities began.

xiaohu21500, 2024-12-20:
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

OK, it is more complicated than i thought, Your information is important for me to start with. I'd like to share if i make some progress.

Closed 2024-12-20.

Thread 15 (2025-01-18):

Not an issue - PD11

Idottt, 2025-01-18:
New to git hub dont know any other way to ask, but I see there is PL11, what about PDLL? Are they the same as far as hardware maybe different software values?
Most of the blogs, online forums are using the PDLL so that’s what I got, then see this.
Nice work btw!

darwinbeing, 2025-01-19:
Thanks for asking! Regarding PL11 vs. PDLL, here’s what I’ve observed:
    The two power supplies perform similarly in most aspects. However, there are some key differences:
    PL11 is manufactured by LiteOn, which seems to excel in software implementation.
    PDLL is produced by Delta Electronics, a company that appears to focus more on hardware design.

Closed 2025-01-25.

Thread 16 (2025-02-01):

HSTNS-PL30 external potentiometer

go-0n-git, 2025-02-01:
this is not a issue... i have a question
for  HSTNS-PL30 could you post a detailed picture of where to solder points to add External Voltage 500 ohm potentiometer, and Amp 500 ohm potentiometer

darwinbeing, 2025-02-03:
#6

go-0n-git, 2025-02-04:
i want to add potentiometers to adjust Voltage and current.  could you give detailed pictures location of solder points.

cotfas, 2025-02-04:
I'm also interested on the PL30 to add an adjustable resistor for voltage mod.

From my understanding is to add a resistor (not sure what value), at the pin of the 220 SMD and to GND.

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

cotfas, 2025-02-04:
Also, the two potentiometers on the top of the board, I understood it right? They are for adjusting Current ?

But what exactly ?

cotfas, 2025-02-04:
@darwinbeing I have these two videos:

https://www.youtube.com/watch?v=eh7FzcV9E4g&t=817s

https://www.youtube.com/watch?v=CMEkzsVtGsU

Could you tell me what value had you used for adjusting the voltage — on the adjustable resistor pot.

Might it be 10kOhm adjustable resistor? (I'm asking this as I saw from the other video, for the same model, they might used the 10k one)

At the moment, I'm only interested in adjusting the voltage till the OVP kicks in, like in your video, 13.8V should be fine for my amp application.

Thank you!
Vlad

darwinbeing, 2025-02-05:
The trimmer marked with "3" can be rotated counterclockwise to reduce the OCP.

cotfas, 2025-02-06:
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

This is what I have.

I did some measurements right now:

The one that is marked with 3 (left side):
—measured both bottom legs of the pot, has = 2,3kOhm
—measured Top + left = 2,3kOhm
—measured Top + Right = 0

The 2nd resistor (marked with 2), from the right:
—measured both bottom legs (the ones from the left side) = 99.3Ohm
—measured left pin and top one(right side) = 0
—measured left pin and right bottom (from the picture, basically it should be the bottom left if resistor would be standup) = 99.3Ohm

@darwinbeing

1. my assumption is that the OCP is set very low? right?
2. what is the purpose of the right adjustable resistor?
3. how much I should rotate the first resistor (marked with 3) to be in the safe zone? or I also need a dummy load and do tests with it?

darwinbeing, 2025-02-06:
The adjustment range of the left trimmer is limited and safe. The right trimmer is for amplifier input offset voltage compensation—do not adjust it.

cotfas, 2025-02-06:
Thank you for your help!

Also wanted to ask, in your video on YT, for the PL30 version, what adjustment resistor value you were using, for adjusting the output voltage (near the 221 SMD) ?

Is it 10k Ohm adjustable resistor?

cotfas, 2025-02-06:
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

https://www.youtube.com/watch?v=eh7FzcV9E4g&t=818s

That blue resistor, what value you were using?

Thank you!

darwinbeing, 2025-02-06:
It's 10k potentiometer.

cotfas, 2025-02-06:
> The adjustment range of the left trimmer is limited and safe. The right trimmer is for amplifier input offset voltage compensation—do not adjust it unless you know what you're doing.

From the schematic that you added, you're talking about the R11 (from the right of the schematic, but from the left of the PCB, marked with 3), that one I can adjust it for OCP? Right?

And R9 I don't touch it.

Correct?

darwinbeing, 2025-02-06:
R11, R12, R13, and R14 make up a voltage divider network. You can adjust them to change the OCP.

cotfas, 2025-02-06:
Perfect! Thank you!

Closed 2025-02-06.

Thread 17 (2025-02-08):

HSTNS-PL11 with older revision

je1gaa, 2025-02-08:
This is question, not a issue.

I am planning to modify HSTNS-PL11 Rev. 09.
Is it possible to apply FW patch to one with older revision?

darwinbeing, 2025-02-08:
Back it up first. Give it a shot—it should work.

je1gaa, 2025-02-08:
Thanks, I will upload it later.
By the way, is it possible to get 14.8~15.0V from PL11 by FW mod?

darwinbeing, 2025-02-08:
I haven’t really dug into the PL11, so I’m not sure if it’s doable. But the PL30 can definitely do it.

je1gaa, 2025-02-18:
I dumped firmware from my HSTNS-PL11 Rev.9.
As github does not allows .hex file to be uploaded with pull request, upload it with .txt.
[PIC16F883.txt](https://github.com/user-attachments/files/18841622/PIC16F883.txt)

je1gaa, 2025-02-20:
I made pull request to upload this file.

Closed 2025-02-09.

Thread 19 (2025-02-24):

HSTNS-PR62

Zorg33, 2025-02-24:
I got a bunch of HSTNS-PR62 1600W HP Flex PSU.
Any solution for Voltage and OVP mod?

darwinbeing, 2025-02-24:
I don’t have this power supply. Could you upload some clear pictures?

Closed 2025-03-04.

Thread 20 (2025-04-03):

In-Circuit Serial Programming and Debugging Pinout

ta2vip, 2025-04-03:
I have a question about the In-Circuit Serial Programming and Debugging pinout.

The pin order specified on the GitHub page does not work correctly on my HSTNS-PD19 REV06F power supply. I am sure that Pin 5 is GND, but in your schematic, Pin 5 appears as +3V VCC.

The following pins are incorrect. Please help me find the correct pin configuration for my power supply. Thank you.

Pinout:
Pin 1 - PGEC
Pin 2 - PGED
Pin 3 - MCLR
Pin 4 - GND
Pin 5 - Vcc (3.3V)

fredmeyer, 2025-04-04:
Pin 5 is GND
Pin 4 is MCLR
Pin 3 is DATA
Pin 2 is CLOCK
Pin 1 is VDD (+5V)

These are the correct pin assignments for the PD19. I’m attaching the original backup of the HEX file.

If you encounter an error during writing, try flashing while the power input is connected.

I’m leaving it here so you can find it later if needed.

[pd19.TXT](https://github.com/user-attachments/files/19605150/pd19.TXT)

darwinbeing, 2025-04-04:
The debug port definition should match the PD30. #2

fredmeyer, 2025-04-07:
Your GitHub page mentions the PL30 pin definitions, but I didn't see anything about PD30. It definitely does not match PL30. The pin definitions for HSTNS-PD19 are as I mentioned above. If you pay attention, in OVP bypass tutorials for the PD19, one leg of the resistors is shown to be soldered to pin number 5. Pin 5 is GND.

fredmeyer, 2025-04-07:
Another thing I’d like to ask is whether the PIC16F877.hex file included for the PD19 in your repo contains the OVP bypass and the modifications to increase the output voltage to 14 volts? Thank you your answer.

ta2vip, 2025-04-24:
My problem is solved. You can close the topic.

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

Closed 2025-04-24.

Thread 21 (2025-04-04):

PL30 Connection issue

BUGBEAR7, 2025-04-04:
Hello

I am trying to connect it to Pickit programmer but no matter what I do it is unable to connect.
I have put 10K resistor on pin 1 and pin 2 on Pickit side. I have soldered 5 wire directly to the connector , I have checked and re checked the connection is good and there is not short while soldering.
PL30       PICKIT
Pin1        Pin5
Pin2        Pin4
Pin3        Pin1
Pin4        Pin3
Pin5        Pin2

Tried while PSU is on , tried when it not connected to power
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

No matter what I do when I select Midrange/1.8v Min. It always shows "No Device Detected". Please help me what am I doing wrong

darwinbeing, 2025-04-04:
Have you tried MPLAB X IDE v6.05? It might help.

BUGBEAR7, 2025-04-04:
That is bit complicated for me , tried but I guess that is not working either

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

Does that 10K resistor have to be connected all the time. Is there anything have to do with putting in debugging mode or something.
I do not understand what I am doing wrong with PICKIT programmer.
Does mains supply have to connected while doing this ?
Do I have to hold any specific buttons while turning it on?

darwinbeing, 2025-04-04:
You don't need the 10K resistor; you should use MPLAB IPE to update the firmware.

BUGBEAR7, 2025-04-04:
Thanks a lot
Just did it via MPLAB IPE

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

Closed 2025-04-04.

Thread 22 (2025-04-29):

HP HSTNS-PD19: Temperature related stability issues (14.4V: 12k/22k/22k)

syssi, 2025-04-29:
Thanks for your great project! I've modified two HSTNS-PD19 power supplies and both don't run stable. I'm using the default configuration from this project / your YouTube video (`OVP1 12k, OVP2 22k, Out 22k`). To be precise: I've damaged the 3.74kOhm resistor at OVP1 like everyone else and replaced the resistor with 3kOhm (`17.7*3.74/(17.7+3.74)`).

The power supply starts fine. The green LED turns on and 14.4V are delivered. After a while the device shuts down. For a second the fan spins up a bit. If I attach a 12V/60W bulb, the supply survives around 60 seconds. At the second attempt, 30s. The fan speed remains inconspicuous.

If I send fresh air through the device using an external fan, the power supply doesn't shut down and is able to deliver the 14.4V without issues. It looks like a temperature issue which isn't handled by the internal fan properly. Do you have some ideas to improve the situation? I've seen some Youtube comments and a [diyaudio thread](https://www.diyaudio.com/community/threads/high-current-supply-for-testing.391159/page-3) with similar issues. I will try to lower the output voltage to 13.8/14V as next step. May be not stressing the power supply that much will bring some stability.

Some collected (mentioned as working) configurations from the Youtube comments:

```
OVP1 22k, OVP2 33k, Out 33k
OVP1 22k, OVP2 27k, Out 30k
OVP1 22k, OVP2 30k, Out 30k
```

darwinbeing, 2025-05-20:
Since you're only using a small load, the heat generated should be very low, and the default fan speed should be enough to handle it. I suggest checking your soldering work—an unstable or poor solder joint might cause shutdowns like this.

For reference, I'm using the same power supply with a 700W load, and it runs stably for over 4 hours without any issues.

Thread 23 (2025-05-03):

14.1V firmware request for HP HSTNS-PL30/42

ninja-zx11, 2025-05-03:
So grateful to you for sharing your fantastic work!!! Successfully uploaded your patched firmware to my PL30 and PL42 with PICkit3 and they are outputting 14.4 Volts.

May I request the patched firmware for PL30/42  that outputs 14.1 Volts.Want to squeeze out little more amps by going down on the volts and I got AGM battery on my BMW E70 and don't want to over charge on super warm days by going over 14.1volts.

Also is it possible to include Over current protection in the firmware so that it shuts down at around 900-950watts output with 120v input to protect itself? I noticed with the patched firmware, voltage starts dropping to 13 volts at around 80-90 amps but power supply didn't shut down to protect itself.

darwinbeing, 2025-05-20:
The Trimmer Potentiometer (left side) marked with "3" can be rotated counterclockwise to reduce the OCP. #16

ninja-zx11, 2025-05-20:
Many Thanks!! I will try that.  Do you think its possible to have a firmware for 14.1 volts. If its too much or not possible, then I will go ahead with the hardware mod.

ninja-zx11, 2025-05-20:
Awesome!! I will try it soon and will let you know.

ninja-zx11, 2025-05-21:
Success!!  Reprogrammed both PL30 and PL42 and both are outputting 14.02V. Tested it with Fluke87V.  I then moved the OCP pot to max counterclockwise and both are shutting around at 74Amps !!. Perfect!!!  Many thanks my friend!!  Please close this issue.

Closed 2025-05-21.

Thread 24 (2025-05-21):

Añadir firmware original HSTNS-PL11

reymond555, 2025-05-21:
Añadir Firmware original Para Fuente HSTNS-PL11, dispongo del programador pickit 5 e extraido el firmware original de este modelo y me gustaria poder añadirlo a tu proyecto ya que si por algun motivo acurriera algun error o alguien necesitara volvera la version original del firmware lo podria hacer con este archivo .hex que estoy tratando de añadir solo que no me permite añadir el archivo a tu proyecto si existiera algun metodo para añadir este te agradeceria que me lo brindaras ya que podria ser de gran ayuda para las personas que se animan a modificar estas fuentes, saludos desde costa rica

darwinbeing, 2025-05-21:
Claro, puedes comprimir el firmware en un archivo .zip y subirlo aquí, luego yo lo integraré al repositorio actual.

reymond555, 2025-05-23:
> Claro, puedes comprimir el firmware en un archivo .zip y subirlo aquí, luego yo lo integraré al repositorio actual.

Adjunto el archivo .Zip con la informacion Necesaria y muchas gracias

[Rev 09 & Rev 12 Original Firmware Factory Firmware.zip](https://github.com/user-attachments/files/20406362/Rev.09.Rev.12.Original.Firmware.Factory.Firmware.zip)

Closed 2025-05-24.

Thread 25 (2025-09-14):

Firmware for PL41

robots, 2025-09-14:
Hello,

I have dumped PL41 firmware. But i am not 100%sure which constants are OVP, OCP, and setpoints. It also seems that the firmware is duplicated - same firmware twice in memory for some reason. I would appreciate if you could shed some light on the internal workings you have discovered :)

[hstns-pl41.zip](https://github.com/user-attachments/files/22322869/hstns-pl41.zip)

IceShiva, 2025-09-14:
It's a dual image layout technology when firmware is updated and someting wrong mcu boots from second image from flash layout, if you didn't correct memory regions defaulted by ghidra/ida dissasemblers you cannot get contants at all because memory secions are not mapped. Guys I saw your's yt shorts about achieving cc mode. I stopped testing this because I was lack of hardware needed for solid test. I stopped on creating switched dummy load for testing transcient response meanwhile studying lot of TI/keysight/Christophe Basso literature and almost get in madness dc is easy ac is hell. Yeah some guy modded 6kw (artesyn) cisco psu to cv/cc power supply but he get rid completelly orginal compensator and did completelly new one but damn so slow and I think it's excludes it for everyday use. So keypoint is decipher compensator values whatever is done (digital/analog) way. Regarding to @darwinbeing shorts some liteons has comensator done using noninverting configuration and I'm not sure that your's one has too, but if yes it very vulnerable to "compensator windup" so when you'll get eg 10amps and you'll want to go higher example 20amps compensator have tendence to windup to max value and this is caused by slow response/ bad gains in compensator.

darwinbeing, 2025-09-14:
I’d really appreciate it if you could share a few clear photos of the secondary control board — the one with the MCU and possibly the phase-shift full-bridge controller. That would help a lot with identifying the circuitry. On similar supplies, AN0, AN1, AN2 and AN3 respectively sample the VCOMP voltage, the secondary-side shunt current, the over-voltage protection signal, and the primary-side current.

IceShiva, 2025-09-14:
Dayumn! That explains stability! I'm not sure that I have some pl30 but whatever I'm ordering few one for test! In mail notifications i saw typical c code definitions. Do you rewriting firmware? What do you think about -48vdc power supplies (on output, not input) eg N77-AC-3KW-V01 I got one and it seems to still hybrid solution where 2 UCC2895 backed by atmel mcu (microchip one) but I believe newer one is also dspic powered. I'm currentelly looking for way to get orginal c2000 programmer in reasonable price because many power related devices is running on that platform (obc from ev, blcd drivers) including server power supplies even from other manufacturers. I also found some schematics from older liteon power supplies like pl11 seems to be already in repo I also got PS-2112-1D-LF  1100/1400w version schematics. I'm really sad because I lost somewhere full spreadsheet from liteon about this power supply including dell and liteon notes and fault analysis. There is any way to contribute in this project? Sorry for being chaotic but I have so many questions. Did you try charge lto/li ion batteries? They have much lowest impedance? Regards.
