darwinbeing/HPServerPSUHack/(list of files, drawings)

Other design files:
references/200W LLC Resonant Converter /200W LLC Resonant Converter Reference Design - EP/PCB Files/Gerbers/05-07149_R0.2.pcb
references/200W LLC Resonant Converter /200W LLC Resonant Converter Reference Design - FJ/PCB Files/Gerbers/05-07149_R0.2.pcb
