darwinbeing/HPServerPSUHack/references/dpsk3-power-buck-average-current-mode-control-1.0.1/dpsk_buck_acmc.X/sources/common/p33c_pral/p33c_adc.h

/*LICENSE *****************************************************************************************
 *
 * Software License Agreement
 *
 * Copyright (R) 2012 Microchip Technology Inc.  All rights reserved. Microchip licenses to you the
 * right to use, modify, copy and distribute Software only when embedded on a Microchip 
 * microcontroller or digital signal controller, which is integrated into your product or third 
 * party product (pursuant to the sublicense terms in the accompanying license agreement).
 *
 * You should refer to the license agreement accompanying this Software for additional information 
 * regarding your rights and obligations.
 *
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
 * ***********************************************************************************************/

#ifndef MCAL_P33SMPS_HSADC_H
#define MCAL_P33SMPS_HSADC_H

#include <xc.h> // include processor files - each processor file is guarded.  
#include <stdint.h> // include standard integer types header file
#include <stdbool.h> // include standard boolean types header file
#include <math.h> // include standard math library header file

#include "p33smps_devices.h"

//#if defined (__MA330049_dsPIC33CH_DPPIM__) || defined (__MA330048_dsPIC33CK_DPPIM__)

#if defined (__P33SMPS_CH__) || defined (__P33SMPS_CK__)


/**************************************************************************************************
 * @brief Header file with additional defines for the dsPIC33FxxGS-ADC SFRs
 * @details
 * The SMPS ADC module offers a number of registers and configuration options. This additional
 * header file contains defines for all required bit-settings. This additional
 * header file contains defines for all required bit-settings of all related registers.
 * This file is an additional header file on top of the generic device header file.
 * ***********************************************************************************************/

// Device-specific Defines

#if defined (__P33SMPS_CH202__) || defined (__P33SMPS_CH202S1__) || \
    defined (__P33SMPS_CH502__) || defined (__P33SMPS_CH502S1__)

    #if defined (__P33SMPS_CH_MSTR__)

        #define ADC_CORE_COUNT          1					// Number of ADC Cores available
        #define ADC_ANINPUT_COUNT       12                  // Number of analog inputs
        #define ADC_SHARED_CORE_INDEX   (ADC_CORE_COUNT - 1)    // Arteficially assigned index for shared ADC core

        #define REG_ADC_CHANNEL_L_MSK   0b0000111111111111
        #define REG_ADC_CHANNEL_H_MSK   0b0000000000000000

    #elif defined (__P33SMPS_CH_SLV1__)

        #define ADC_CORE_COUNT          3					// Number of ADC Cores available
        #define ADC_ANINPUT_COUNT       11                  // Number of analog inputs
        #define ADC_SHARED_CORE_INDEX   (ADC_CORE_COUNT - 1)    // Arteficially assigned index for shared ADC core

        #define REG_ADC_CHANNEL_L_MSK   0b0000011111111111
        #define REG_ADC_CHANNEL_H_MSK   0b0000000000000000

    #endif

#elif defined (__P33SMPS_CH203__) || defined (__P33SMPS_CH205__) || \
      defined (__P33SMPS_CH203S1__) || defined (__P33SMPS_CH205S1__) || \
      defined (__P33SMPS_CH503__) || defined (__P33SMPS_CH505__) || \
      defined (__P33SMPS_CH503S1__) || defined (__P33SMPS_CH505S1__)

    #if defined (__P33SMPS_CH_MSTR__)

        #define ADC_CORE_COUNT          1					// Number of ADC Cores available
        #define ADC_ANINPUT_COUNT       16                  // Number of analog inputs
        #define ADC_SHARED_CORE_INDEX   (ADC_CORE_COUNT - 1)    // Arteficially assigned index for shared ADC core

        #define REG_ADC_CHANNEL_L_MSK   0b1111111111111111
        #define REG_ADC_CHANNEL_H_MSK   0b0000000000000000

    #elif defined (__P33SMPS_CH_SLV1__)

        #define ADC_CORE_COUNT          3					// Number of ADC Cores available
        #define ADC_ANINPUT_COUNT       15                  // Number of analog inputs
        #define ADC_SHARED_CORE_INDEX   (ADC_CORE_COUNT - 1)    // Arteficially assigned index for shared ADC core

        #define REG_ADC_CHANNEL_L_MSK   0b0111111111111111
        #define REG_ADC_CHANNEL_H_MSK   0b0000000000000000

    #endif

#elif defined (__P33SMPS_CH206__) || defined (__P33SMPS_CH208__) || \
      defined (__P33SMPS_CH206S1__) || defined (__P33SMPS_CH208S1__) || \
      defined (__P33SMPS_CH506__) || defined (__P33SMPS_CH508__) || \
      defined (__P33SMPS_CH506S1__) || defined (__P33SMPS_CH508S1__)

    #if defined (__P33SMPS_CH_MSTR__)

        #define ADC_CORE_COUNT          1					// Number of ADC Cores available
        #define ADC_ANINPUT_COUNT       16                  // Number of analog inputs
        #define ADC_SHARED_CORE_INDEX   (ADC_CORE_COUNT - 1)    // Arteficially assigned index for shared ADC core

        #define ADC_ADCMP_COUNT         4 // Number of ADC Digital Comparators
        #define ADC_ADFL_COUNT          4 // Number of ADC Digital Filters

        #define REG_ADC_CHANNEL_L_MSK   0b1111111111111111
        #define REG_ADC_CHANNEL_H_MSK   0b0000000000000000
    
    #elif defined (__P33SMPS_CH_SLV1__)

        #define ADC_CORE_COUNT          3					// Number of ADC Cores available
        #define ADC_ANINPUT_COUNT       18                  // Number of analog inputs
        #define ADC_SHARED_CORE_INDEX   (ADC_CORE_COUNT - 1)    // Arteficially assigned index for shared ADC core

        #define ADC_ADCMP_COUNT         4 // Number of ADC Digital Comparators
        #define ADC_ADFL_COUNT          4 // Number of ADC Digital Filters

        #define REG_ADC_CHANNEL_L_MSK   0b1111111111111111
        #define REG_ADC_CHANNEL_H_MSK   0b0000000000000011

    #endif

#elif defined (__MA330048_dsPIC33CK_DPPIM__)

    #define ADC_CORE_COUNT          3 // Number of ADC Cores available
    #define ADC_SHARED_CORE_INDEX   (uint16_t)(ADC_CORE_COUNT - 1) // Arteficially assigned index for shared ADC core

    #define ADC_ADCMP_COUNT         4 // Number of ADC Digital Comparators
    #define ADC_ADFL_COUNT          4 // Number of ADC Digital Filters

    #if defined (__P33SMPS_CK202__) || defined (__P33SMPS_CK502__)
        #define ADC_ANINPUT_COUNT       12                  // Number of analog inputs without alternative or internal ports
        #define REG_ADC_CHANNEL_L_MSK   0b0000111111111111
        #define REG_ADC_CHANNEL_H_MSK   0b0000001100000000
    #elif defined (__P33SMPS_CK203__) || defined (__P33SMPS_CK503__)
        #define ADC_ANINPUT_COUNT       16                  // Number of analog inputs without alternative or internal ports
        #define REG_ADC_CHANNEL_L_MSK   0b1111111111111111
        #define REG_ADC_CHANNEL_H_MSK   0b0000001100000000
    #elif defined (__P33SMPS_CK205__) || defined (__P33SMPS_CK505__)
        #define ADC_ANINPUT_COUNT       19                  // Number of analog inputs without alternative or internal ports
        #define REG_ADC_CHANNEL_L_MSK   0b1111111111111111
        #define REG_ADC_CHANNEL_H_MSK   0b0000001100000111
    #elif defined (__P33SMPS_CK206__) || defined (__P33SMPS_CK506__)
        #define ADC_ANINPUT_COUNT       20                  // Number of analog inputs without alternative or internal ports
        #define REG_ADC_CHANNEL_L_MSK   0b1111111111111111
        #define REG_ADC_CHANNEL_H_MSK   0b0000001100001111
    #elif defined (__P33SMPS_CK208__) || defined (__P33SMPS_CK508__)
        #define ADC_ANINPUT_COUNT       24                  // Number of analog inputs without alternative or internal ports
        #define REG_ADC_CHANNEL_L_MSK   0b1111111111111111
        #define REG_ADC_CHANNEL_H_MSK   0b0000001111111111
    #endif
    

    // All devices

    #define ADC_CORE_ANA0  0  // ADC input is assigned to dedicated ADC core (#0) => Alternative input to ADC Core #0
    #define ADC_CORE_ANA1  1  // ADC input is assigned to dedicated ADC core (#1) => Alternative input to ADC Core #1

    #define ADC_CORE_AN24  2  // ADC input is assigned to shared ADC core (#2) => Temperature Sensor
    #define ADC_CORE_AN25  2  // ADC input is assigned to shared ADC core (#2) => Bandgap Reference

    #define ADC_CORE_AN0   0  // ADC input is assigned to dedicated ADC core (#0)
    #define ADC_CORE_AN1   1  // ADC input is assigned to dedicated ADC core (#1)
    #define ADC_CORE_AN2   2  // ADC input is assigned to shared ADC core (#2)
    #define ADC_CORE_AN3   2  // ADC input is assigned to shared ADC core (#3)
    #define ADC_CORE_AN4   2  // ADC input is assigned to shared ADC core (#4)
    #define ADC_CORE_AN5   2  // ADC input is assigned to shared ADC core (#5)
    #define ADC_CORE_AN6   2  // ADC input is assigned to shared ADC core (#6)
    #define ADC_CORE_AN7   2  // ADC input is assigned to shared ADC core (#7)
    #define ADC_CORE_AN8   2  // ADC input is assigned to shared ADC core (#8)
    #define ADC_CORE_AN9   2  // ADC input is assigned to shared ADC core (#9)
    #define ADC_CORE_AN10  2  // ADC input is assigned to shared ADC core (#10)
    #define ADC_CORE_AN11  2  // ADC input is assigned to shared ADC core (#11)


    #if defined (__P33SMPS_CK203__) || defined (__P33SMPS_CK503__) || \
        defined (__P33SMPS_CK205__) || defined (__P33SMPS_CK505__) || \
        defined (__P33SMPS_CK206__) || defined (__P33SMPS_CK506__) || \
        defined (__P33SMPS_CK208__) || defined (__P33SMPS_CK508__)
    // 36-/48-/64-/80-pin devices only
    #define ADC_CORE_AN12  2  // ADC input is assigned to shared ADC core (#12)
    #define ADC_CORE_AN13  2  // ADC input is assigned to shared ADC core (#13)
    #define ADC_CORE_AN14  2  // ADC input is assigned to shared ADC core (#14)
    #define ADC_CORE_AN15  2  // ADC input is assigned to shared ADC core (#15)
    #endif

    #if defined (__P33SMPS_CK205__) || defined (__P33SMPS_CK505__) || \
        defined (__P33SMPS_CK206__) || defined (__P33SMPS_CK506__) || \
        defined (__P33SMPS_CK208__) || defined (__P33SMPS_CK508__)
    // 48-/64-/80-pin devices only
    #define ADC_CORE_AN16  2  // ADC input is assigned to shared ADC core (#16)
    #define ADC_CORE_AN17  2  // ADC input is assigned to shared ADC core (#17)
    #define ADC_CORE_AN18  2  // ADC input is assigned to shared ADC core (#19)
    #endif

    #if defined (__P33SMPS_CK206__) || defined (__P33SMPS_CK506__) || \
        defined (__P33SMPS_CK208__) || defined (__P33SMPS_CK508__)
    // 64-/80-pin devices only
    #define ADC_CORE_AN19  2  // ADC input is assigned to shared ADC core (#20)
    #endif
    
    #if defined (__P33SMPS_CK208__) || defined (__P33SMPS_CK508__)
    // 80-pin devices only
    #define ADC_CORE_AN20  2  // ADC input is assigned to shared ADC core (#21)
    #define ADC_CORE_AN21  2  // ADC input is assigned to shared ADC core (#22)
    #define ADC_CORE_AN22  2  // ADC input is assigned to shared ADC core (#23)
    #define ADC_CORE_AN23  2  // ADC input is assigned to shared ADC core (#24)
    #endif

    typedef enum {
        ADCORE_AN0  = 0,  // ADC input is assigned to dedicated ADC core (#0)
        ADCORE_ANA0 = 0,  // ADC input is assigned to dedicated ADC core (#0)
        ADCORE_AN1  = 1,  // ADC input is assigned to dedicated ADC core (#1)
        ADCORE_ANA1 = 1,  // ADC input is assigned to dedicated ADC core (#1)
        ADCORE_AN2  = 2,  // ADC input is assigned to shared ADC core (#2)
        ADCORE_AN3  = 2,  // ADC input is assigned to shared ADC core (#3)
        ADCORE_AN4  = 2,  // ADC input is assigned to shared ADC core (#4)
        ADCORE_AN5  = 2,  // ADC input is assigned to shared ADC core (#5)
        ADCORE_AN6  = 2,  // ADC input is assigned to shared ADC core (#6)
        ADCORE_AN7  = 2,  // ADC input is assigned to shared ADC core (#7)
        ADCORE_AN8  = 2,  // ADC input is assigned to shared ADC core (#8)
        ADCORE_AN9  = 2,  // ADC input is assigned to shared ADC core (#9)
        ADCORE_AN10 = 2,  // ADC input is assigned to shared ADC core (#10)
        ADCORE_AN11 = 2,  // ADC input is assigned to shared ADC core (#11)
    #if defined (__P33SMPS_CK203__) || defined (__P33SMPS_CK503__) || \
        defined (__P33SMPS_CK205__) || defined (__P33SMPS_CK505__) || \
        defined (__P33SMPS_CK206__) || defined (__P33SMPS_CK506__) || \
        defined (__P33SMPS_CK208__) || defined (__P33SMPS_CK508__)
        ADCORE_AN12 = 2,  // ADC input is assigned to shared ADC core (#12)
        ADCORE_AN13 = 2,  // ADC input is assigned to shared ADC core (#13)
        ADCORE_AN14 = 2,  // ADC input is assigned to shared ADC core (#14)
        ADCORE_AN15 = 2,  // ADC input is assigned to shared ADC core (#15)
    #endif

    #if defined (__P33SMPS_CK205__) || defined (__P33SMPS_CK505__) || \
        defined (__P33SMPS_CK206__) || defined (__P33SMPS_CK506__) || \
        defined (__P33SMPS_CK208__) || defined (__P33SMPS_CK508__)
        ADCORE_AN16 = 2,  // ADC input is assigned to shared ADC core (#16)
        ADCORE_AN17 = 2,  // ADC input is assigned to shared ADC core (#17)
        ADCORE_AN18 = 2,  // ADC input is assigned to shared ADC core (#18)
    #endif

    #if defined (__P33SMPS_CK206__) || defined (__P33SMPS_CK506__) || \
        defined (__P33SMPS_CK208__) || defined (__P33SMPS_CK508__)
        ADCORE_AN19 = 2,  // ADC input is assigned to shared ADC core (#19)
    #endif
    
    #if defined (__P33SMPS_CK208__) || defined (__P33SMPS_CK508__)
        ADCORE_AN20 = 2,  // ADC input is assigned to shared ADC core (#20)
        ADCORE_AN21 = 2,  // ADC input is assigned to shared ADC core (#21)
        ADCORE_AN22 = 2,  // ADC input is assigned to shared ADC core (#22)
        ADCORE_AN23 = 2,  // ADC input is assigned to shared ADC core (#23)
    #endif

        ADCORE_AN24 = 2,  // ADC input is assigned to shared ADC core (#24) => Temperature Sensor
        ADCORE_AN25 = 2   // ADC input is assigned to shared ADC core (#25) => Bandgap Reference
    }ADC_CORE_INDEX_e;

#else

    #pragma message "=== selected device is not defined and may not be supported ==="

#endif

// The following define is used for bit masks and configuration registers depending on the number
// of available ADC cores and will be used by multiple defines throughout the library
#define ADCON4_VALID_ADCORE_BIT_MSK   (uint32_t)(ADCORE_REGISTER_BIT_MSK)

// bits are added for each dedicated core, shared core is always available (highest index)
#if (ADC_CORE_COUNT > 1)
    #define ADCORE_REGISTER_BIT_MSK   ((uint32_t)(pow(2, (ADC_CORE_COUNT-1)) - 1) | 0x0080) 
#else
    #define ADCORE_REGISTER_BIT_MSK   ((uint32_t)0x0080) // only the shared core is present
#endif

// Device-specific Defines
#ifndef DEVICE_DEFAULT_AVDD
    #define DEVICE_DEFAULT_AVDD 3.300 // if device VDD is not defined in this project, define it for standard value of 3.3V
#endif

#define ADC_VREF            DEVICE_DEFAULT_AVDD     // ADC reference voltage in [V]
#define ADC_RES_BIT         12.0    // ADC resolution in integer
#define ADC_RES             (uint16_t)(pow(2, ADC_RES_BIT)-1)    // ADC resolution in integer
#define ADC_SCALER          (float)(((float)(ADC_RES))/((float)(ADC_VREF))) // ADC Scaling in ticks/V
#define ADC_GRANULARITY     (float)(ADC_REF / pow(2.0, ADC_RES)) // ADC granularity in [V/tick]
    
#define ADC_ANx_INTERRUPT_ENABLE        1       // Bit setting for enabled interrupts of a dedicated analog input
#define ADC_ANx_INTERRUPT_DISABLE       0       // Bit setting for disabled interrupts of a dedicated analog input

#define ADC_ANx_EARLY_INTERRUPT_ENABLE  1       // Bit setting for enabled early interrupts of a dedicated analog input
#define ADC_ANx_EARLY_INTERRUPT_DISABLE 0       // Bit setting for disabled early interrupts of a dedicated analog input

// General Flags
#define ADC_OFF							0b0		// Flag is used to shut down the adc module
#define ADC_ON							0b1		// Flag is used to enable the adc module

// REGISTER ADCON1L/H: ANALOG-TO-DIGITAL CONTROL REGISTER 1 LOW/HIGH

#define REG_ADCON1_VALID_DATA_WRITE_MSK     0x00E0A000 		// Bit mask used to set unimplemented bits to zero
#define REG_ADCON1_VALID_DATA_READ_MSK      0x00E0A000		// Bit mask used to read unimplemented bits as zero
#define REG_ADCON1_OFF_STATE_WRITE_MSK      0x00E02000 		// Bit mask used to set unimplemented bits to zero

// REGISTER ADCON1L: ANALOG-TO-DIGITAL CONTROL REGISTER 1 LOW

#define REG_ADCON1L_VALID_DATA_MSK          0b1010000000000000		// Bit mask used to set unimplemented bits to zero
#define REG_ADCON1L_DISABLED_MSK            0b0111111111111111
#define REG_ADCON1L_RESET                   0b0000000000000000      // Reset ADCON 1 Low Register

// REGISTER ADCON1H: ANALOG-TO-DIGITAL CONTROL REGISTER 1 HIGH

#define REG_ADCON1H_RESET                   0b0000000001100000      // Reset ADCON 1 High Register
#define REG_ADCON1H_VALID_DATA_MSK          0b0000000011100000		// Bit mask used to read unimplemented bits as zero

#define REG_ADCON1H_EXCLUDE_SHRADC_CFG_MSK	0b1111111110011111		// Bit mask used to read register settings without shared ADC core resolution

#define REG_ADCON1L_ADON_ENABLED		    0b1000000000000000      // Turn ADC Module On
#define REG_ADCON1L_ADON_DISABLED		    0b0000000000000000      // Turn ADC Module Off

typedef enum {
    ADCON1_ADON_ENABLED = 0b1, // ADC module is enabled
    ADCON1_ADON_DISABLED = 0b0 // ADC module is disabled
} ADCON1_ADON_e; // ADC Enable bit

#define REG_ADCON1L_ADSIDL_STOP			0b0010000000000000      // Module Discontinues Operation in Idle Mode
#define REG_ADCON1L_ADSIDL_RUN			0b0000000000000000      // Module Continues Operation in Idle Mode

typedef enum {
    ADCON1_ADSIDL_STOP = 0b1, // Discontinues module operation when device enters Idle mode
    ADCON1_ADSIDL_RUN = 0b0 // Continues module operation in Idle mode
} ADCON1_ADSIDL_e; // ADC Stop in Idle Mode bit


// REGISTER ADCON1H: ANALOG-TO-DIGITAL CONTROL REGISTER 1 HIGH

#define REG_ADCON1H_FORM_FRACTIONAL		0b0000000010000000      // Result Number Format = Fractional
#define REG_ADCON1H_FORM_INTEGER		0b0000000000000000      // Result Number Format = Integer

typedef enum {
    ADCON1_FORM_FRACTIONAL = 0b1, // Fractional Data Output Format
    ADCON1_FORM_INTEGER = 0b0 // Integer Data Output Format
} ADCON1_FORM_e; // Fractional Data Output Format bit

#define REG_ADCON1H_SHRRES_12BIT        0b0000000001100000      // Set for 12-bit operation
#define REG_ADCON1H_SHRRES_10BIT        0b0000000001000000      // Set for 10-bit operation
#define REG_ADCON1H_SHRRES_8BIT         0b0000000000100000      // Set for 8-bit operation
#define REG_ADCON1H_SHRRES_6BIT         0b0000000000000000      // Set for 6-bit operation

typedef enum {
    ADCORE_RES_12BIT = 0b11, // 12-bit resolution
    ADCORE_RES_10BIT = 0b10, // 10-bit resolution
    ADCORE_RES_8BIT = 0b01, // 8-bit resolution
    ADCORE_RES_6BIT = 0b00 // 6-bit resolution
} ADCOREx_RES_e; // Shared & Dedicated ADC Core Resolution Selection bits

typedef union {
    struct {
        volatile unsigned : 13;              // Bit 12-0: (reserved)
        volatile ADCON1_ADSIDL_e adsidl : 1; // Bit 13: ADC Stop in Idle Mode bit
        volatile unsigned : 1;               // Bit 14: (reserved)
        volatile ADCON1_ADON_e adon : 1;     // Bit 15: ADC Enable bit
    } __attribute__((packed)) bits;          // ADCON1H: ADC CONTROL REGISTER 1 LOW
    volatile uint16_t value;
}ADCON1L_t;     // ADCON1L: ADC CONTROL REGISTER 1 LOW


typedef union {
    struct {
        volatile unsigned : 5;              // Bit 4-0: (reserved)
        volatile ADCOREx_RES_e shrres : 2;  // Bit 6-5: Shared ADC Core Resolution Selection bits
        volatile ADCON1_FORM_e form : 1;    // Bit 7: Fractional Data Output Format bit
        volatile unsigned : 8;              // Bit 15-8: (reserved)
    } __attribute__((packed))bits;          // ADCON1H: ADC CONTROL REGISTER 1 HIGH
    volatile uint16_t value;
}ADCON1H_t;     // ADCON1H: ADC CONTROL REGISTER 1 HIGH


typedef union {
    struct {
        volatile ADCON1L_t adcon1l;     // ADCON1L: ADC CONTROL REGISTER 1 LOW
        volatile ADCON1H_t adcon1h;     // ADCON1H: ADC CONTROL REGISTER 1 HIGH
    } __attribute__((packed))bits;      // ADCON1: ADC CONTROL REGISTER 1 HIGH/LOW
    volatile uint32_t value;
} ADCON1_t; // ADCON1: ADC CONTROL REGISTER 1 HIGH/LOW

// REGISTERS ADCON2L/H: ANALOG-TO-DIGITAL CONTROL REGISTER 2 LOW/HIGH

#define REG_ADCON2_VALID_DATA_WRITE_MSK  0xC3FFDF7F		// Bit mask used to set unimplemented bits to zero
#define REG_ADCON2_VALID_DATA_READ_MSK   0xC3FFDF7F		// Bit mask used to set unimplemented bits to zero


// REGISTER ADCON2L: ANALOG-TO-DIGITAL CONTROL REGISTER 2 HIGH

#define REG_ADCON2L_RESET                  0b0000000000000000      // Reset ADCON 2 Low Register
#define REG_ADCON2L_VALID_DATA_MSK		   0b1101111101111111		// Bit mask used to set unimplemented bits to zero

#define REG_ADCON2L_SHRADC_CFG_MSK         0b0001011101111111      // Bit-Mask eliminating all bits not concerning the shared ADC core configuration
#define REG_ADCON2L_REF_CFG_MSK            0b1100000000000000      // Bit-Mask eliminating all bits not concerning the bandgap reference configuration
#define REG_ADCON2L_EXCLUDE_SHRADC_CFG_MSK 0b1111100010000000      // Bit-Mask eliminating all shared ADC core configuration bits 

// REGISTER ADCON2H: ANALOG-TO-DIGITAL CONTROL REGISTER 2 HIGH

#define REG_ADCON2H_RESET                  0b0000000000000000      // Reset ADCON 2 High Register
#define REG_ADCON2H_VALID_DATA_MSK		   0b1100001111111111		// Bit mask used to set unimplemented bits to zero

#define REG_ADCON2H_SHRADC_CFG_MSK         0b0000001111111111      // Bit-Mask eliminating all bits not concerning the shared ADC core configuration
#define REG_ADCON2H_REF_CFG_MSK            0b1100000000000000      // Bit-Mask eliminating all bits not concerning the bandgap reference configuration
#define REG_ADCON2H_REF_STAT_READ_MSK      0b1100000000000000      // Bit-Mask for reading the bandgap reference status bits
#define REG_ADCON2H_EXCLUDE_SHRADC_CFG_MSK 0b1111110000000000      // Bit-Mask eliminating all shared ADC core configuration bits 


#define REG_ADCON2L_REFCIE_ENABLED      0b1000000000000000      // Interrupt on Band Gap & Reference Voltage Ready
#define REG_ADCON2L_REFCIE_DISABLED     0b0000000000000000      // No Interrupt on Band Gap & Reference Voltage Ready

typedef enum {
    ADCON2_REFCIE_ENABLED = 0b1, // Common interrupt will be generated when the band gap becomes ready
    ADCON2_REFCIE_DISABLED = 0b0 // Common interrupt is disabled for the band gap ready event
} ADCON2_REFCIE_e; // Band Gap and Reference Voltage Ready Common Interrupt Enable bit

#define REG_ADCON2L_REFERCIE_ENABLED    0b0100000000000000      // Interrupt on Band Gap or Reference Voltage Error
#define REG_ADCON2L_REFERCIE_DISABLED   0b0000000000000000      // No Interrupt on Band Gap or Reference Voltage Error

typedef enum {
    ADCON2_REFERCIE_ENABLED = 0b1, // Common interrupt will be generated when a band gap or reference voltage error is detected
    ADCON2_REFERCIE_DISABLED = 0b0 // Common interrupt is disabled for the band gap and reference voltage error event
} ADCON2_REFERCIE_e; // Band Gap or Reference Voltage Error Common Interrupt Enable bit

#define REG_ADCON2L_EIEN_ENABLED        0b0001000000000000      // Early Interrupts Enabled
#define REG_ADCON2L_EIEN_DISABLED       0b0000000000000000      // Early Interrupts Disabled

typedef enum {
    ADCON2_EIEN_ENABLED = 0b1, // The early interrupt feature is enabled for the input channel interrupts (when the EISTATx flag is set)
    ADCON2_EIEN_DISABLED = 0b0 // The individual interrupts are generated when conversion is done (when the ANxRDY flag is set)
} ADCON2_EIEN_e; // Early Interrupts Enable bit

#define REG_ADCON2L_PTGEN_ENABLED      0b0001000000000000      // External Conversion Request Interface bit: PTG Access ON
#define REG_ADCON2L_PTGEN_DISABLED     0b0000000000000000      // External Conversion Request Interface bit: PTG Access OFF

typedef enum {
    ADCON2_PTGEN_ENABLED = 0b1, // External Conversion Request Interface bit: PTG Access ON
    ADCON2_PTGEN_DISABLED = 0b0 // External Conversion Request Interface bit: PTG Access OFF
} ADCON2_PTGEN_e; // External Conversion Request Interface bit


#define REG_ADCON2L_SHREISEL_8TAD       0b0000011100000000      // Early Interrupts 8 TADs before READY
#define REG_ADCON2L_SHREISEL_7TAD       0b0000011000000000      // Early Interrupts 7 TADs before READY
#define REG_ADCON2L_SHREISEL_6TAD       0b0000010100000000      // Early Interrupts 6 TADs before READY
#define REG_ADCON2L_SHREISEL_5TAD       0b0000010000000000      // Early Interrupts 5 TADs before READY
#define REG_ADCON2L_SHREISEL_4TAD       0b0000001100000000      // Early Interrupts 4 TADs before READY
#define REG_ADCON2L_SHREISEL_3TAD       0b0000001000000000      // Early Interrupts 3 TADs before READY
#define REG_ADCON2L_SHREISEL_2TAD       0b0000000100000000      // Early Interrupts 2 TADs before READY
#define REG_ADCON2L_SHREISEL_1TAD       0b0000000000000000      // Early Interrupts 1 TADs before READY

typedef enum {
    ADCORE_EISEL_8TAD = 0b111, // Early interrupt is set and interrupt is generated 8 TADCORE clocks prior to when the data is ready
    ADCORE_EISEL_7TAD = 0b110, // Early interrupt is set and interrupt is generated 7 TADCORE clocks prior to when the data is ready
    ADCORE_EISEL_6TAD = 0b101, // Early interrupt is set and interrupt is generated 6 TADCORE clocks prior to when the data is ready
    ADCORE_EISEL_5TAD = 0b100, // Early interrupt is set and interrupt is generated 5 TADCORE clocks prior to when the data is ready
    ADCORE_EISEL_4TAD = 0b011, // Early interrupt is set and interrupt is generated 4 TADCORE clocks prior to when the data is ready
    ADCORE_EISEL_3TAD = 0b010, // Early interrupt is set and interrupt is generated 3 TADCORE clocks prior to when the data is ready
    ADCORE_EISEL_2TAD = 0b001, // Early interrupt is set and interrupt is generated 2 TADCORE clocks prior to when the data is ready
    ADCORE_EISEL_1TAD = 0b000 // Early interrupt is set and interrupt is generated 1 TADCORE clocks prior to when the data is ready
} ADCOREx_EISEL_e; // Shared & Dedicated Core Early Interrupt Time Selection bits enumeration

#define REG_SHRADCS_MSK     0b0000000001111111      // Bit-Mask to filter on clock divider value bits
#define REG_SHRADCS(x)      ((x >> 1) & REG_SHRADCS_MSK) 	// Shared ADC Core Input Clock Divider bits. (x indicates the effective divider ratio)

typedef enum {
    ADCORE_ADCS_DEFAULT = 0b0000000, // 2 source clock periods (TCORESRC) per TAD clock period (TADCORE)
    ADCORE_ADCS_DIV2 = 0b0000001, // 2 source clock periods (TCORESRC) per TAD clock period (TADCORE)
    ADCORE_ADCS_DIV4 = 0b0000010, // 4 source clock periods (TCORESRC) per TAD clock period (TADCORE)
    ADCORE_ADCS_DIV6 = 0b0000011, // 6 source clock periods (TCORESRC) per TAD clock period (TADCORE)
    ADCORE_ADCS_DIV8 = 0b0000100, // 8 source clock periods (TCORESRC) per TAD clock period (TADCORE)
    ADCORE_ADCS_DIV10 = 0b0000101, // 10 source clock periods (TCORESRC) per TAD clock period (TADCORE)
    ADCORE_ADCS_DIV12 = 0b0000110, // 12 source clock periods (TCORESRC) per TAD clock period (TADCORE)
    ADCORE_ADCS_DIV14 = 0b0000111, // 14 source clock periods (TCORESRC) per TAD clock period (TADCORE)
    ADCORE_ADCS_DIV16 = 0b0001000, // 16 source clock periods (TCORESRC) per TAD clock period (TADCORE)
    ADCORE_ADCS_DIV18 = 0b0001001, // 18 source clock periods (TCORESRC) per TAD clock period (TADCORE)
    ADCORE_ADCS_DIV20 = 0b0001010, // 20 source clock periods (TCORESRC) per TAD clock period (TADCORE)
    ADCORE_ADCS_DIV22 = 0b0001011, // 22 source clock periods (TCORESRC) per TAD clock period (TADCORE)
    ADCORE_ADCS_DIV24 = 0b0001100, // 24 source clock periods (TCORESRC) per TAD clock period (TADCORE)
    ADCORE_ADCS_DIV26 = 0b0001101, // 26 source clock periods (TCORESRC) per TAD clock period (TADCORE)
    ADCORE_ADCS_DIV28 = 0b0001110, // 28 source clock periods (TCORESRC) per TAD clock period (TADCORE)
    ADCORE_ADCS_DIV30 = 0b0001111, // 30 source clock periods (TCORESRC) per TAD clock period (TADCORE)
    ADCORE_ADCS_DIV32 = 0b0010000, // 32 source clock periods (TCORESRC) per TAD clock period (TADCORE)
    ADCORE_ADCS_DIV34 = 0b0010001, // 34 source clock periods (TCORESRC) per TAD clock period (TADCORE)
    ADCORE_ADCS_DIV36 = 0b0010010, // 36 source clock periods (TCORESRC) per TAD clock period (TADCORE)
    ADCORE_ADCS_DIV38 = 0b0010011, // 38 source clock periods (TCORESRC) per TAD clock period (TADCORE)
    ADCORE_ADCS_DIV40 = 0b0010100, // 40 source clock periods (TCORESRC) per TAD clock period (TADCORE)
    ADCORE_ADCS_DIV42 = 0b0010101, // 42 source clock periods (TCORESRC) per TAD clock period (TADCORE)
    ADCORE_ADCS_DIV44 = 0b0010110, // 44 source clock periods (TCORESRC) per TAD clock period (TADCORE)
    ADCORE_ADCS_DIV46 = 0b0010111, // 46 source clock periods (TCORESRC) per TAD clock period (TADCORE)
    ADCORE_ADCS_DIV48 = 0b0011000, // 48 source clock periods (TCORESRC) per TAD clock period (TADCORE)
    ADCORE_ADCS_DIV50 = 0b0011001, // 50 source clock periods (TCORESRC) per TAD clock period (TADCORE)
    ADCORE_ADCS_DIV52 = 0b0011010, // 52 source clock periods (TCORESRC) per TAD clock period (TADCORE)
    ADCORE_ADCS_DIV54 = 0b0011011, // 54 source clock periods (TCORESRC) per TAD clock period (TADCORE)
    ADCORE_ADCS_DIV56 = 0b0011100, // 56 source clock periods (TCORESRC) per TAD clock period (TADCORE)
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
    ADCORE_ADCS_DIV250 = 0b1111101, // 250 source clock periods (TCORESRC) per TAD clock period (TADCORE)
    ADCORE_ADCS_DIV252 = 0b1111110, // 252 source clock periods (TCORESRC) per TAD clock period (TADCORE)
    ADCORE_ADCS_DIV254 = 0b1111111 // 254 source clock periods (TCORESRC) per TAD clock period (TADCORE)
} ADCOREx_ADCS_e; // Shared & Dedicated ADC core source clock divider selection enumeration


#define REG_ADCON2H_REFRDY_READY     0b1000000000000000   // Band gap is ready
#define REG_ADCON2H_REFRDY_NOT_READY 0b0000000000000000   // Band gap is not ready

typedef enum {
    ADCON2_REFRDY_READY = 0b1, // Band gap is ready
    ADCON2_REFRDY_NOT_READY = 0b0 // Band gap is not ready
} ADCON2_REFRDY_e; // Band Gap and Reference Voltage Ready Flag bit

#define REG_ADCON2H_REFERR_FAIL      0b0100000000000000   // Band gap failure after ADC peripehral was enabled
#define REG_ADCON2H_REFERR_OK        0b0000000000000000   // No Band gap / reference voltage error was detected

typedef enum {
    ADCON2_REFERR_FAIL = 0b1, // Band gap failure after the ADC module was enabled (ADON = 1)
    ADCON2_REFERR_OK = 0b0 // No band gap error was detected
} ADCON2_REFERR_e; // Band Gap or Reference Voltage Error Flag bit

typedef struct {
    volatile unsigned : 14;              // Bit 13-0: (blanked out here)
    volatile ADCON2_REFERR_e referr : 1; // Bit 14: Band Gap/Vref error flag bit
    volatile ADCON2_REFRDY_e refrdy : 1; // Bit 15: Band Gap/Vref status flag bit
} __attribute__((packed))ADCON2_REFSTAT_t; // Band Gap Reference status


#define REG_ADCON2H_SHRSAMC_MSK         0b0000001111111111      // Bit-Mask to filter on clock periods value bits
#define REG_ADCON2H_SHRSAMC(Tdaclk)     ((Tdaclk-2) & REG_ADCON2H_SHRSAMC_MSK) 		// Shared ADC Core Sample Time Selection bits

typedef enum {
    ADCORE_SAMC_DEFAULT = 0b0000000000, // Sampling time of 2 TADCORE clock periods
    ADCORE_SAMC_0002 = 0b0000000000, // Sampling time of 2 TADCORE clock periods
    ADCORE_SAMC_0003 = 0b0000000001, // Sampling time of 3 TADCORE clock periods
    ADCORE_SAMC_0004 = 0b0000000010, // Sampling time of 4 TADCORE clock periods
    ADCORE_SAMC_0005 = 0b0000000011, // Sampling time of 5 TADCORE clock periods
    ADCORE_SAMC_0006 = 0b0000000100, // Sampling time of 6 TADCORE clock periods
    ADCORE_SAMC_0007 = 0b0000000101, // Sampling time of 7 TADCORE clock periods
    ADCORE_SAMC_0008 = 0b0000000110, // Sampling time of 8 TADCORE clock periods
    ADCORE_SAMC_0009 = 0b0000000111, // Sampling time of 9 TADCORE clock periods
    ADCORE_SAMC_0010 = 0b0000001000, // Sampling time of 10 TADCORE clock periods
    ADCORE_SAMC_0011 = 0b0000001001, // Sampling time of 11 TADCORE clock periods
    ADCORE_SAMC_0012 = 0b0000001010, // Sampling time of 12 TADCORE clock periods
    ADCORE_SAMC_0013 = 0b0000001011, // Sampling time of 13 TADCORE clock periods
    ADCORE_SAMC_0014 = 0b0000001100, // Sampling time of 14 TADCORE clock periods
    ADCORE_SAMC_0015 = 0b0000001101, // Sampling time of 15 TADCORE clock periods
    ADCORE_SAMC_0016 = 0b0000001110, // Sampling time of 16 TADCORE clock periods
    ADCORE_SAMC_0017 = 0b0000001111, // Sampling time of 17 TADCORE clock periods
    ADCORE_SAMC_0018 = 0b0000010000, // Sampling time of 18 TADCORE clock periods
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
    ADCORE_SAMC_0862 = 0b1101011100, // Sampling time of 862 TADCORE clock periods
    ADCORE_SAMC_0863 = 0b1101011101, // Sampling time of 863 TADCORE clock periods
    ADCORE_SAMC_0864 = 0b1101011110, // Sampling time of 864 TADCORE clock periods
    ADCORE_SAMC_0865 = 0b1101011111, // Sampling time of 865 TADCORE clock periods
    ADCORE_SAMC_0866 = 0b1101100000, // Sampling time of 866 TADCORE clock periods
    ADCORE_SAMC_0867 = 0b1101100001, // Sampling time of 867 TADCORE clock periods
    ADCORE_SAMC_0868 = 0b1101100010, // Sampling time of 868 TADCORE clock periods
    ADCORE_SAMC_0869 = 0b1101100011, // Sampling time of 869 TADCORE clock periods
    ADCORE_SAMC_0870 = 0b1101100100, // Sampling time of 870 TADCORE clock periods
    ADCORE_SAMC_0871 = 0b1101100101, // Sampling time of 871 TADCORE clock periods
    ADCORE_SAMC_0872 = 0b1101100110, // Sampling time of 872 TADCORE clock periods
    ADCORE_SAMC_0873 = 0b1101100111, // Sampling time of 873 TADCORE clock periods
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
