darwinbeing/HPServerPSUHack/(commit log)

2023-03-03 Update schematic
2023-05-15 Upload PICO FW
2023-05-15 Update PICO fw
2023-11-21 Add PD19 MOD Schematic
2024-08-18 Update firmware to support I2C bus control for PSU power on/off
2024-09-06 Update README.md: Current Sense Amplifier
2024-09-06 Update current sense amplifier circuit
2025-01-13 PL42: Adjust output voltage to 14.48V without hardware modification
2025-01-13 Add references directory
    Created a new directory named 'references' to store example codes,
    documentation, and other project-related materials.
    [DecodedConfigMemories.txt]
2025-01-14 PL30: Updated firmware to set output voltage to 14.48V. This implementation does not require hardware modifications
2025-09-05 Changed PL30 to a 20A constant-current charger
2025-10-25 Add DSPIC33FJ64GS606 REV12 OUTPUT 14.75V 20A CC, MOD HW
2025-10-26 PL30 REV 12 OUTPUT 14.8V 20CC R11 182 Ohms FW
2025-11-02 OVP Voltage Scaling Logic
2025-11-15 Adding pic of Voltage measurement after upvolt mod with 24k resistors.
2025-11-15 Adding resistor values to readme.md and marking resistors in the image
2025-11-23 Added HSTNS-PD19 Rev.02F firmware
    MODEL: DPS-1200FB-1 A
    Regulatory Model No.: HSTNS-PD19
    REV.: 02F
    Generic Part No.: 570451-001
    Part No.: 570451-101
    Spare Part No.: 579229-001
    Controller: PIC16F887 @TQFP-44
2025-11-29 Add support for seamless CV/CC switching and PSU Enable/Disable via I2C
    - Implement direct mode switching between CV and CC without restart
    - Add I2C commands to enable and disable the PSU
    - Update firmware logic to ensure stable transitions and error handling
    - Improve compatibility with PL30 hardware
2026-02-04 Add PD52 firmware: 14V/14.4V/14.8V output, no HW changes
2026-02-13 PL30 REV12: Add I2C interface for PSU CC adjustment
2026-02-14 PL30 REV12: Update PSU feedback divider resistor from 220Ω to 182Ω to ensure proper operation
2026-02-17 200W LLC Resonant Converter
    [03-07149_R0.2.sch, 05-07149_R0.2.pcb, BOM with Output Filter.xls, BOM without Output Filter.xls, LLC Efficiency Calculations with Output Filter.xls, LLC Efficiency Calculations without Output Filter.xls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]
2026-02-28 Update PICO Watt Meter
2026-02-28 Update Microchip PowerSmart DCLD
2026-02-28 Update README for HP HSTNS models and PICO details
    Updated model references from PL42 to PD44 and PD52 in the README. Removed redundant sections and added new content about the PL30 PICO Watt Meter.
2026-02-28 Revise README with firmware and resistor updates
    Updated notes on voltage divider resistor and firmware.
2026-03-04 Add PD44 I2C protocol
2026-03-16 HSTNS-PD44: modify output/OVP divider network and update firmware to enable 20A constant-current output
2026-03-20 Revise 2P2Z transfer function and firmware details
    Updated the 2P2Z transfer function section and improved descriptions of the firmware's functionality, including closed-loop voltage regulation.
2026-03-20 Revise firmware and I2C protocol sections in README
    Updated sections on I2C protocol and HSTNS-PD44 firmware, added schematic reverse engineering details, and included mathematical equations for output voltage calculations.
2026-05-19 docs: compress README images to cut page load size
    Re-encode the 26 large photos/screenshots referenced by README
    (mostly 4032x3024 phone PNGs, ~400 MB total) to JPEG q85 scaled
    to a 2000px max edge, and update the reference links accordingly.
    Total README image payload drops ~400 MB -> 27 MB. Small
    schematics/diagrams are kept as PNG to avoid JPEG ringing.
